jcampos83/Offgridforall_SHS5/SHS_DCDC/Reading/USB A Pinout.jpg

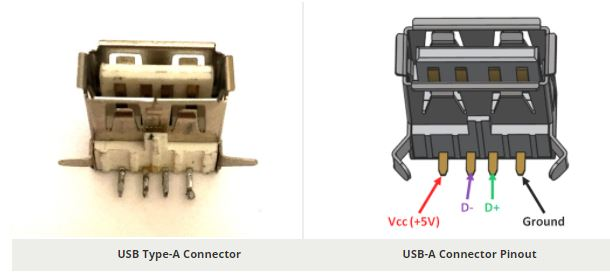
SHS_DCDC/Reading/USB A Pinout.jpg
