jcampos83/Offgridforall_SHS5/SHS_DCDC/Components/MCU/ESP32/ESP32ProgrammingDiagram-970x1024.png

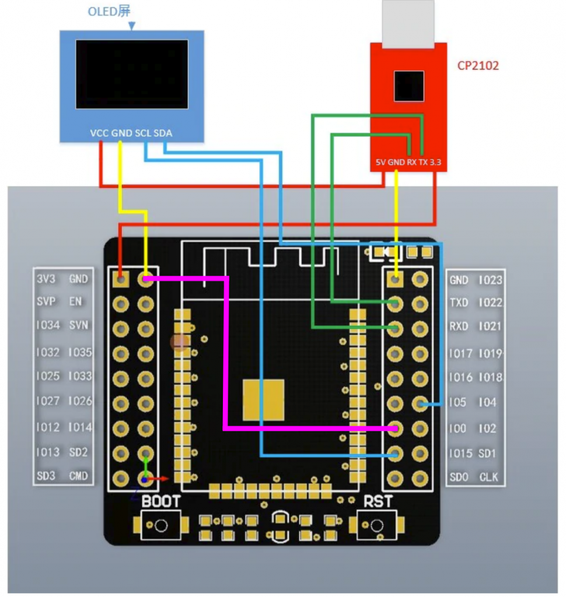
SHS_DCDC/Components/MCU/ESP32/ESP32ProgrammingDiagram-970x1024.png
