jcampos83/Offgridforall_SHS5/SHS_DCDC/Components/MCU/ESP32/ESP32 dev kit schem example.jpg

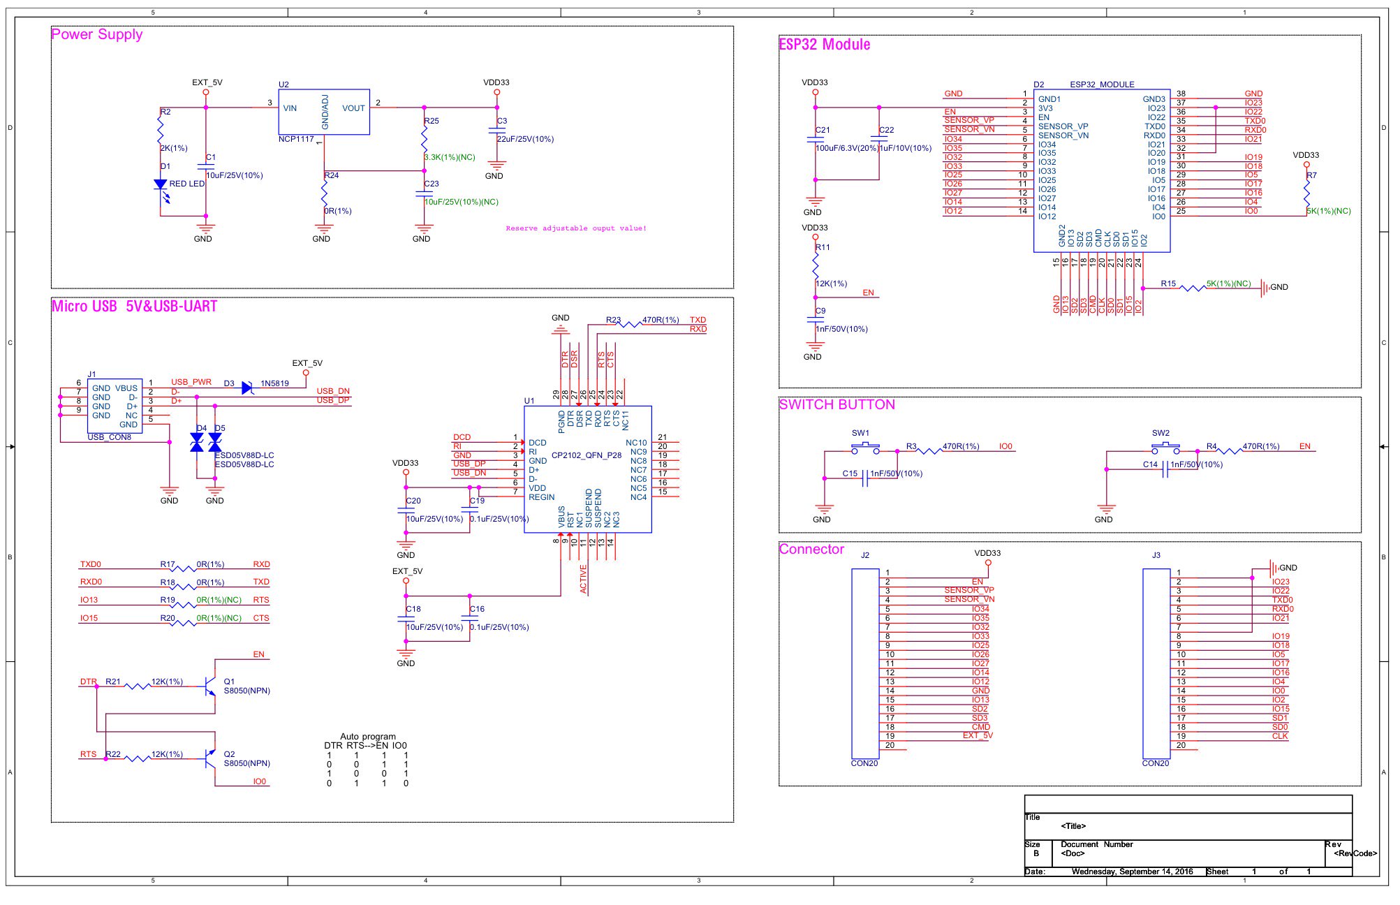
SHS_DCDC/Components/MCU/ESP32/ESP32 dev kit schem example.jpg
