jcampos83/Offgridforall_SHS5/SHS_DCDC/Components/3D model/KEYSTONE - 5029.step

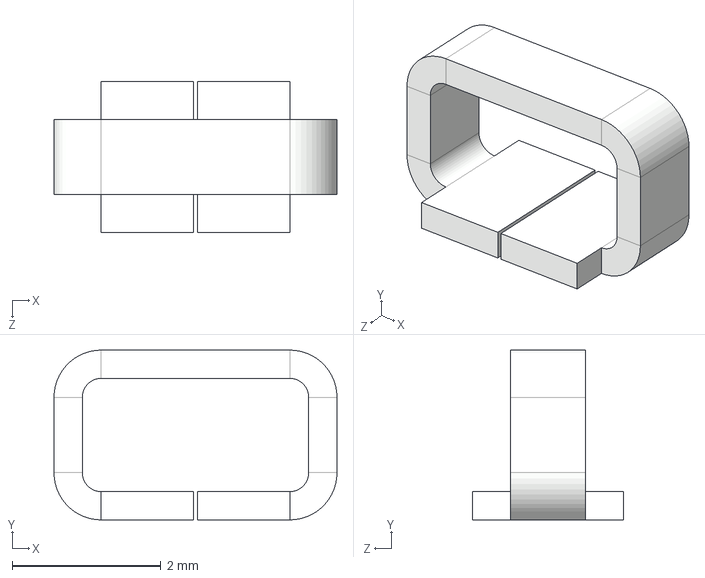
[picture p4: CAD file, 2023-10-24]
SHS_DCDC/Components/3D model/KEYSTONE - 5029.step
3.81 x 2.29 x 2.03 mm
