jcampos83/Offgridforall_SHS5/SHS_DCDC/Components/3D model/BIVAR__INC_VLP-400-F.step

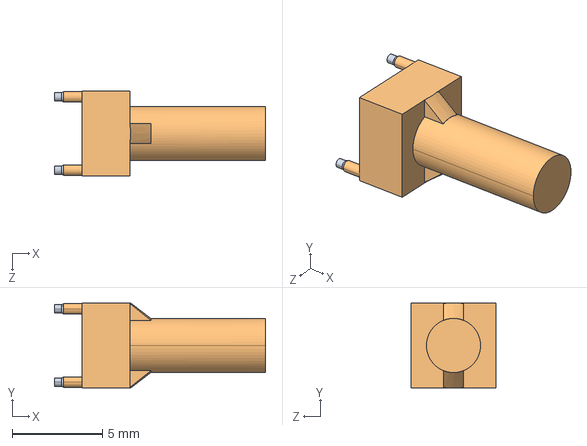
[picture p5: CAD file, 2023-09-13]
SHS_DCDC/Components/3D model/BIVAR__INC_VLP-400-F.step
11.7 x 4.70 x 4.70 mm
