jcampos83/Offgridforall_SHS5/SHS_DCDC/Components/3D model/PTS645SM43SMTR92LFS.stp

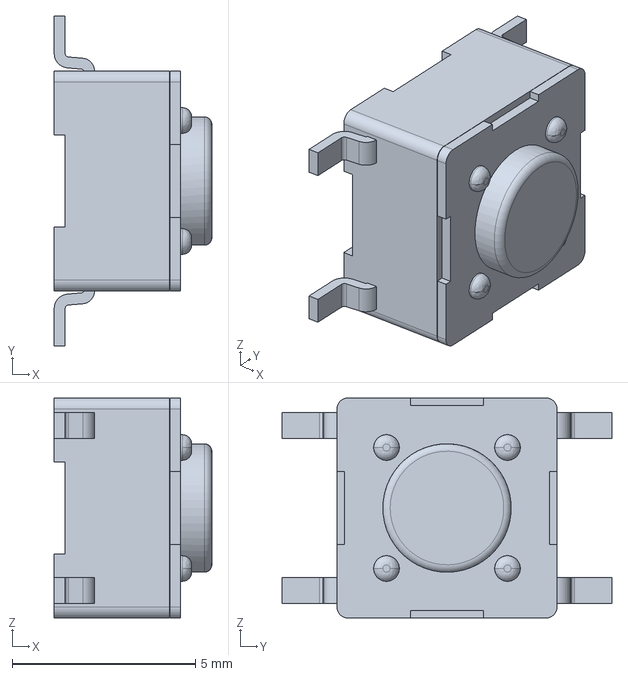
[picture p6: CAD file, 2023-08-12]
SHS_DCDC/Components/3D model/PTS645SM43SMTR92LFS.stp
4.30 x 9.00 x 6.00 mm
