jcampos83/Offgridforall_SHS5/SHS_DCDC/Components/3D model/PJ-059A.stp

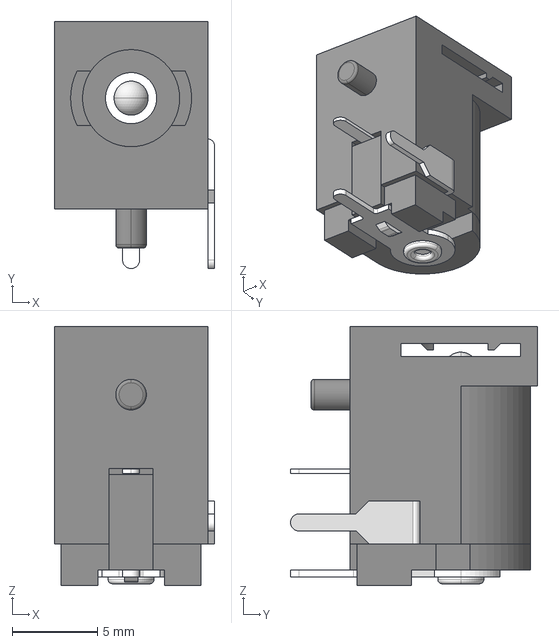
[picture p7: CAD file, 2023-04-24]
SHS_DCDC/Components/3D model/PJ-059A.stp
9.40 x 14.5 x 15.2 mm
