jcampos83/Offgridforall_SHS5/SHS_DCDC/Components/3D model/TSOT23-8_MP3414A_MNP.step

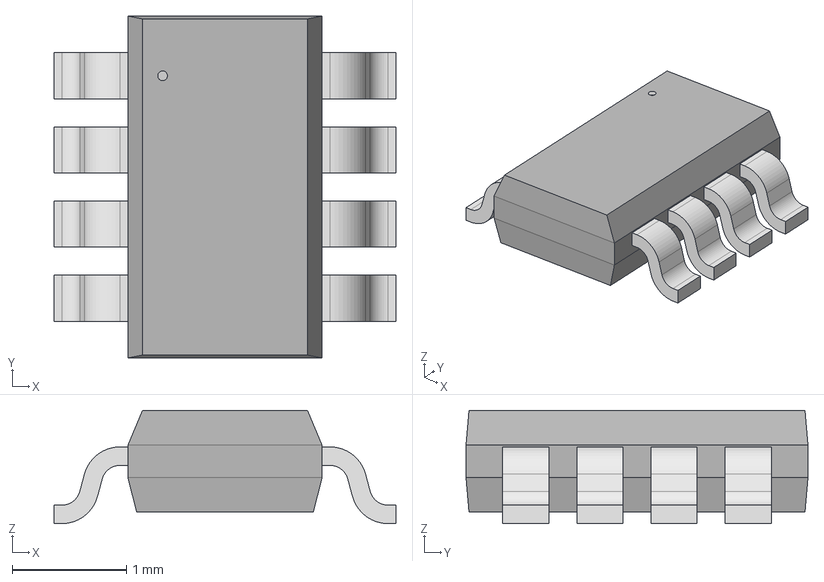
[picture p8: CAD file, 2023-04-24]
SHS_DCDC/Components/3D model/TSOT23-8_MP3414A_MNP.step
3.00 x 3.00 x 0.993 mm
