jcampos83/Offgridforall_SHS5/SHS_DCDC/Components/3D model/XTAL_ECX-34R_ECS.step

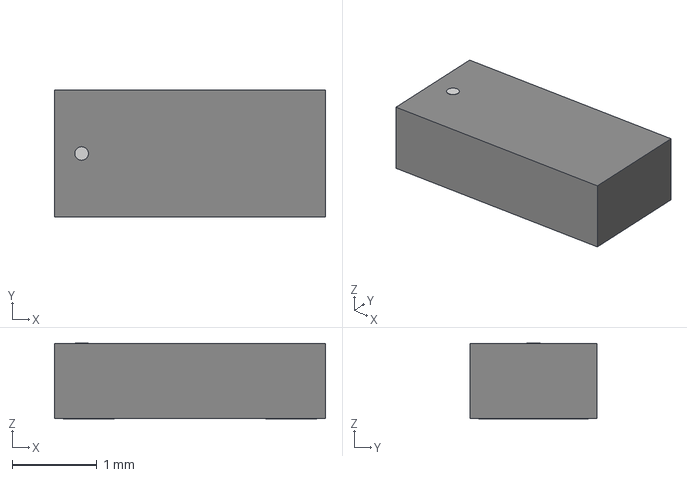
[picture p9: CAD file, 2023-04-24]
SHS_DCDC/Components/3D model/XTAL_ECX-34R_ECS.step
3.20 x 1.50 x 0.892 mm
