jcampos83/Offgridforall_SHS5/SHS_DCDC/Components/3D model/TL1105SFxxxx.stp

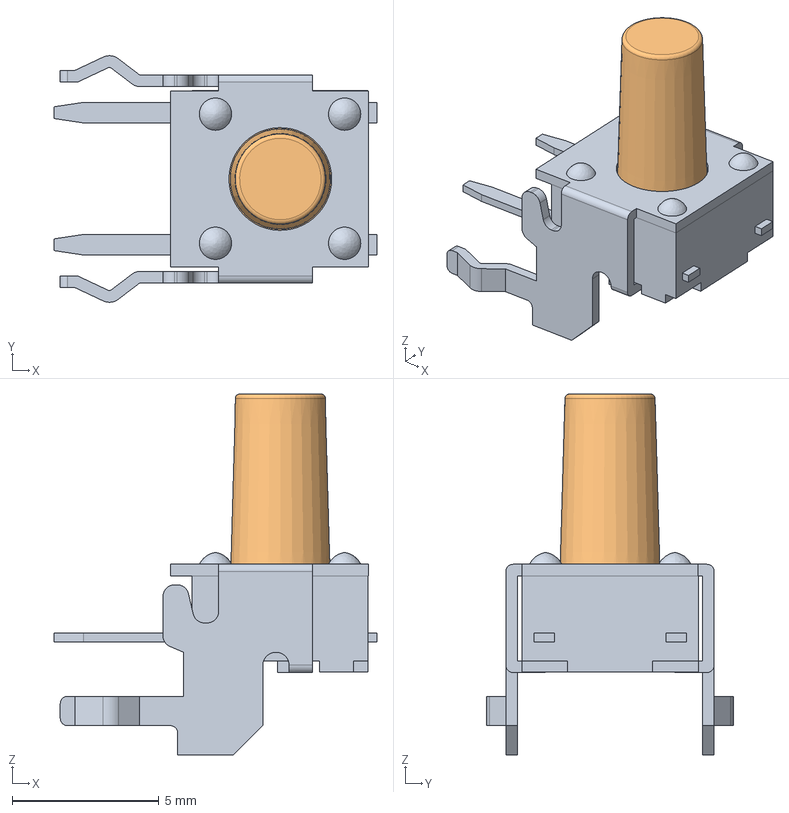
[picture p10: CAD file, 2023-04-24]
SHS_DCDC/Components/3D model/TL1105SFxxxx.stp
11.0 x 8.40 x 12.3 mm
