jcampos83/Offgridforall_SHS5/SHS_DCDC/Components/3D model/IND_TAIYO_NR8040_TAY.step

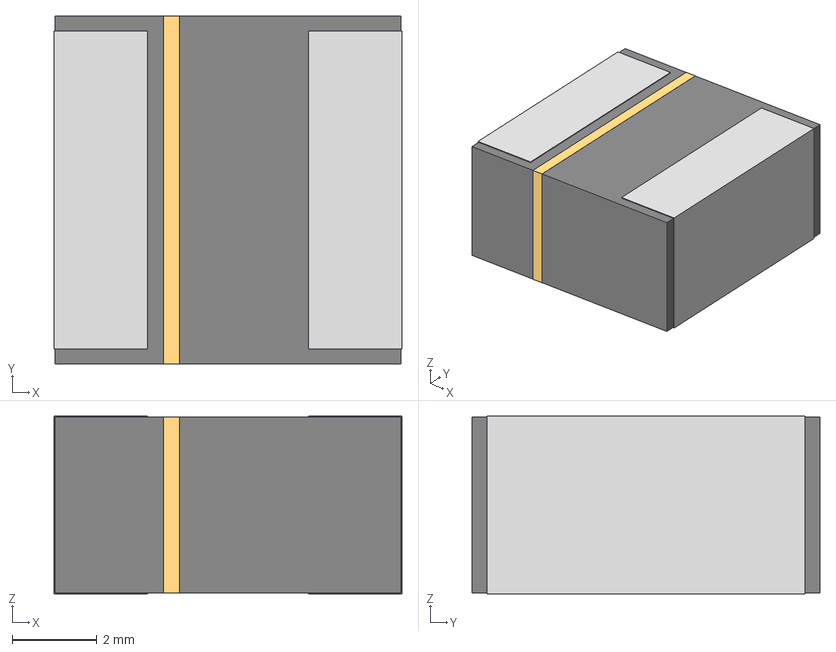
[picture p11: CAD file, 2023-04-17]
SHS_DCDC/Components/3D model/IND_TAIYO_NR8040_TAY.step
8.20 x 8.21 x 4.19 mm
