jcampos83/Offgridforall_SHS5/SHS_DCDC/Components/3D model/LMV358IDR.stp

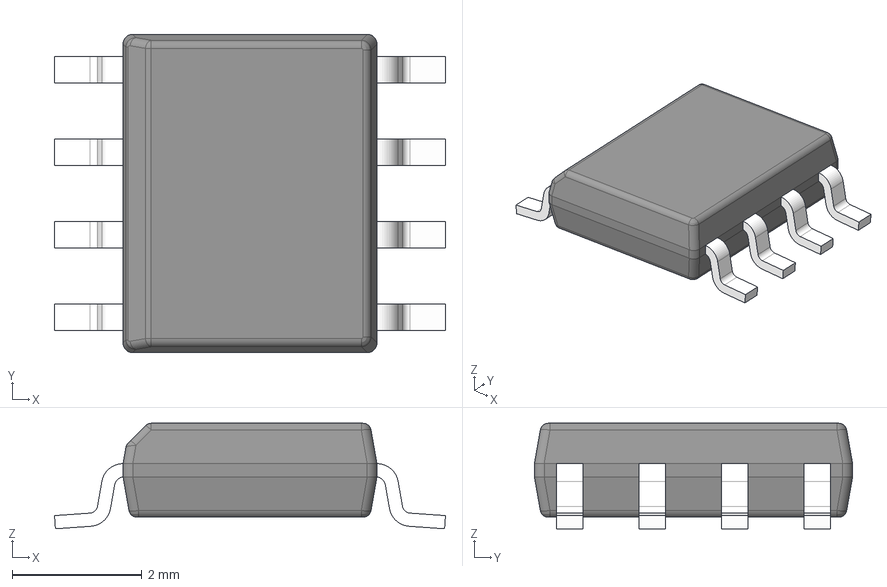
[picture p12: CAD file, 2023-04-17]
SHS_DCDC/Components/3D model/LMV358IDR.stp
6.02 x 4.90 x 1.63 mm
BODY-SO
LEAD-D0008A x 8
