jcampos83/Offgridforall_SHS5/SHS_DCDC/Components/3D model/USB-A-S-S-W-TH.stp

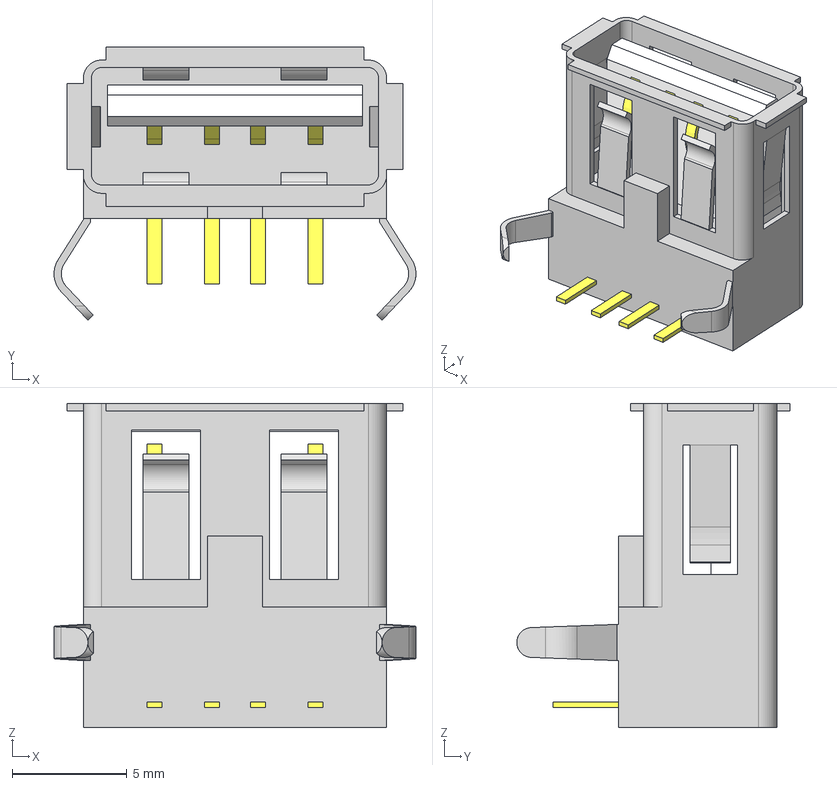
[picture p13: CAD file, 2023-04-17]
SHS_DCDC/Components/3D model/USB-A-S-S-W-TH.stp
15.7 x 11.9 x 14.1 mm
USB-A-S-TH_P
USB-A-S-W-TH_B
USB-A-S-TH_S
