jcampos83/Offgridforall_SHS5/SHS_DCDC/Components/3D model/IND_TAIYO_NR6028_TAY.step

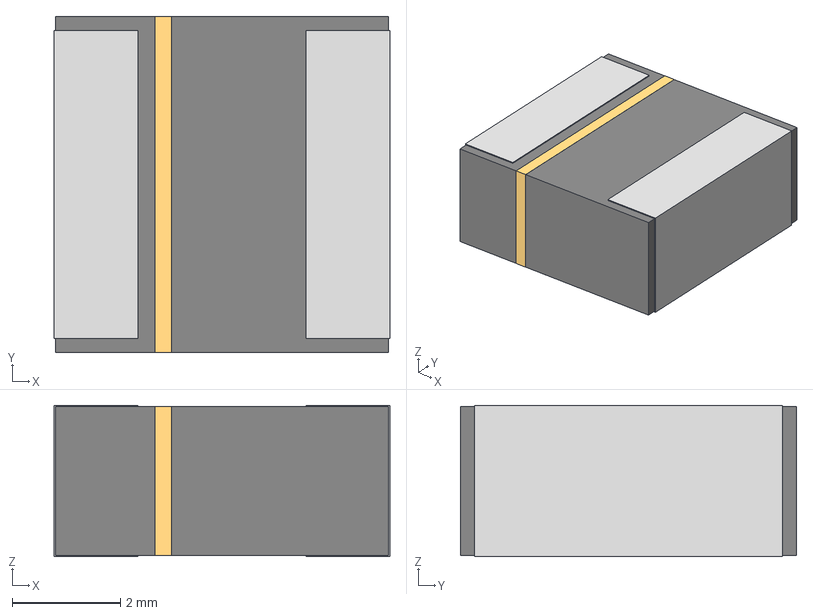
[picture p14: CAD file, 2023-04-17]
SHS_DCDC/Components/3D model/IND_TAIYO_NR6028_TAY.step
6.20 x 6.20 x 2.79 mm
