jcampos83/Offgridforall_SHS5/SHS_DCDC/Components/3D model/TL1105QFxxxx.stp

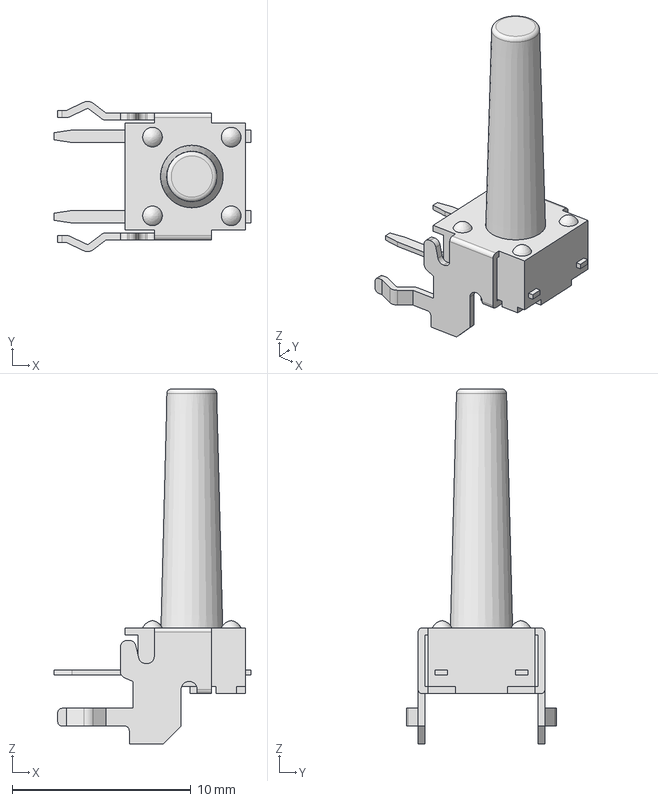
[picture p15: CAD file, 2023-04-17]
SHS_DCDC/Components/3D model/TL1105QFxxxx.stp
11.0 x 8.40 x 19.9 mm
