jcampos83/Offgridforall_SHS5/SHS_DCDC/Components/3D model/CUI_DEVICES_PJ-202A.step

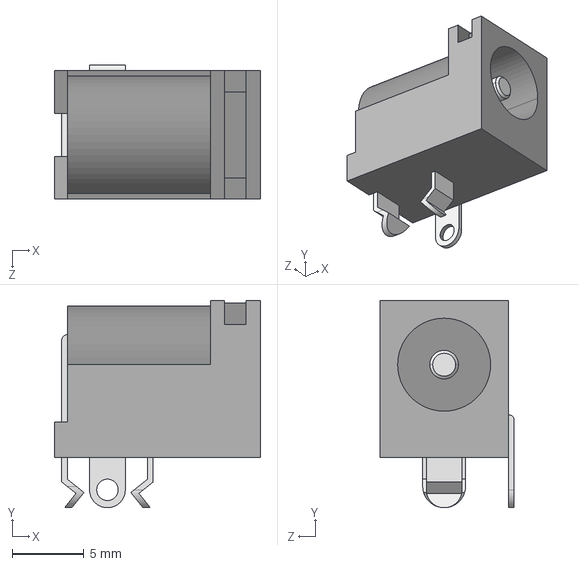
[picture p16: CAD file, 2023-04-17]
SHS_DCDC/Components/3D model/CUI_DEVICES_PJ-202A.step
14.4 x 14.5 x 9.40 mm
