jcampos83/Offgridforall_SHS5/SHS_DCDC/Components/3D model/RT8299 WDFN.step

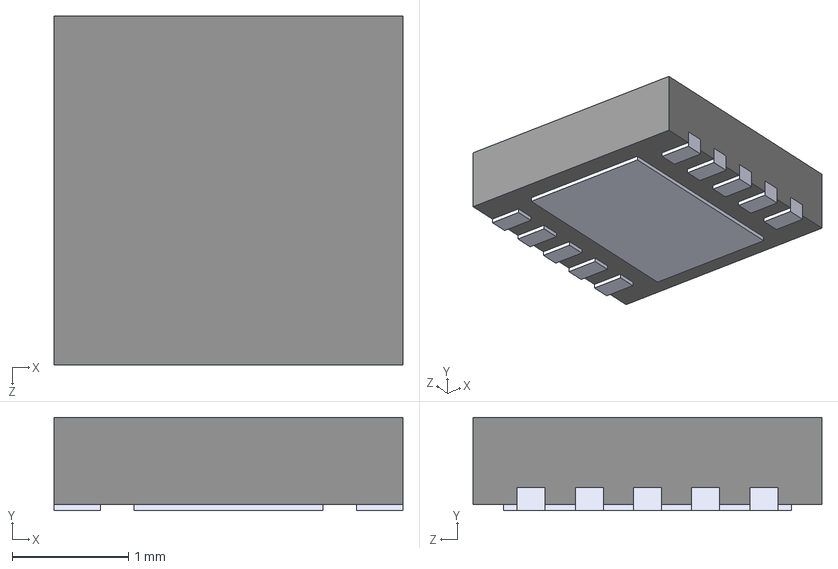
[picture p17: CAD file, 2021-10-31]
SHS_DCDC/Components/3D model/RT8299 WDFN.step
3.00 x 0.8 x 3.00 mm
