jcampos83/Offgridforall_SHS5/SHS_DCDC/Components/3D model/LMV324AIDR.STEP

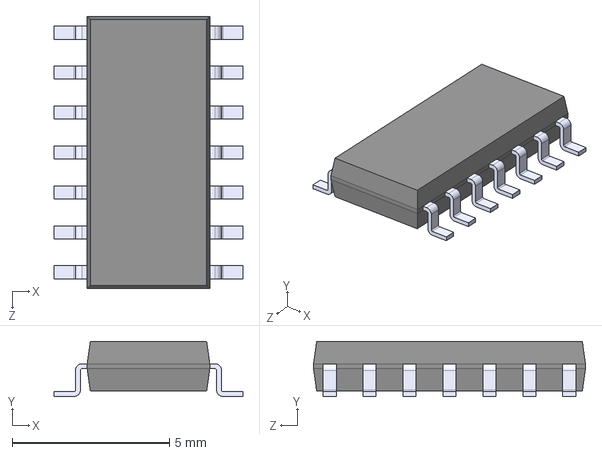
[picture p18: CAD file, 2021-10-04]
SHS_DCDC/Components/3D model/LMV324AIDR.STEP
6.00 x 1.75 x 8.65 mm
