jcampos83/Offgridforall_SHS5/SHS_DCDC/Components/3D model/RJ45_54602-908LFc.stp

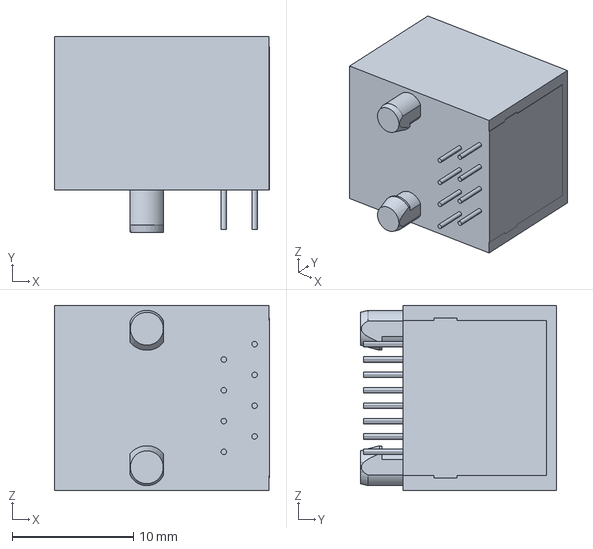
[picture p19: CAD file, 2021-10-04]
SHS_DCDC/Components/3D model/RJ45_54602-908LFc.stp
17.7 x 16.2 x 15.3 mm
