jcampos83/Offgridforall_SHS5/SHS_DCDC/Components/3D model/BK-18650-PC8.STEP

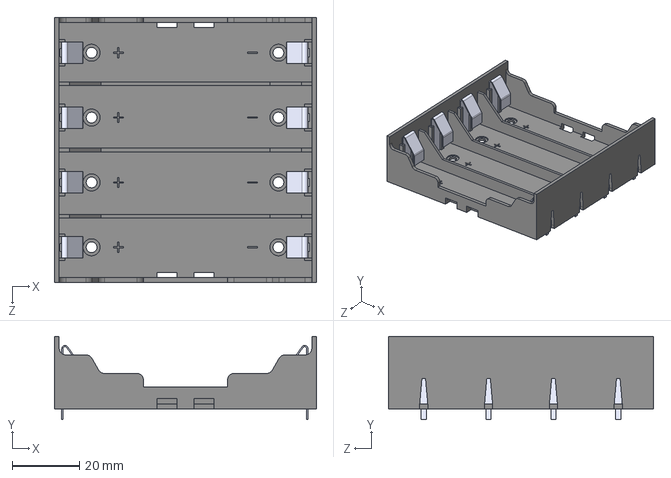
[picture p20: CAD file, 2021-10-04]
SHS_DCDC/Components/3D model/BK-18650-PC8.STEP
78.0 x 24.7 x 78.8 mm
