jcampos83/Offgridforall_SHS5/SHS_DCDC/Components/3D model/Keystone - 1108.STEP

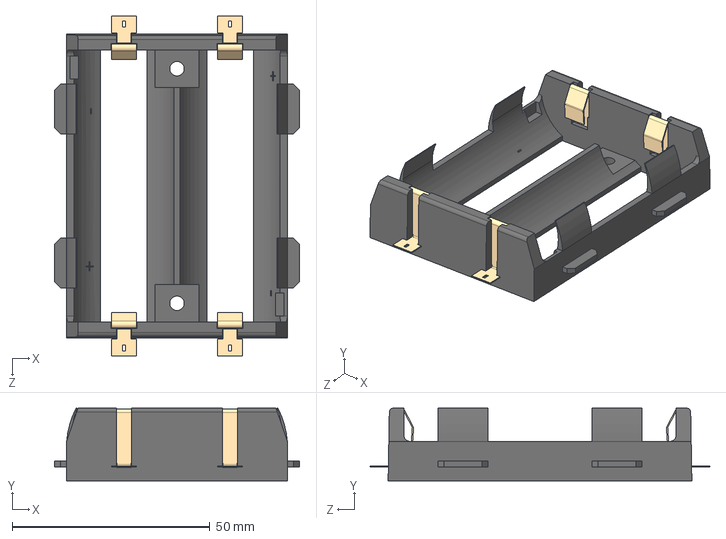
[picture p21: CAD file, 2021-10-04]
SHS_DCDC/Components/3D model/Keystone - 1108.STEP
62.0 x 18.4 x 86.0 mm
