jcampos83/Offgridforall_SHS5/SHS_DCDC/Components/DCDC Converter/Richtek - Buck_RT8299_footprint.pdf

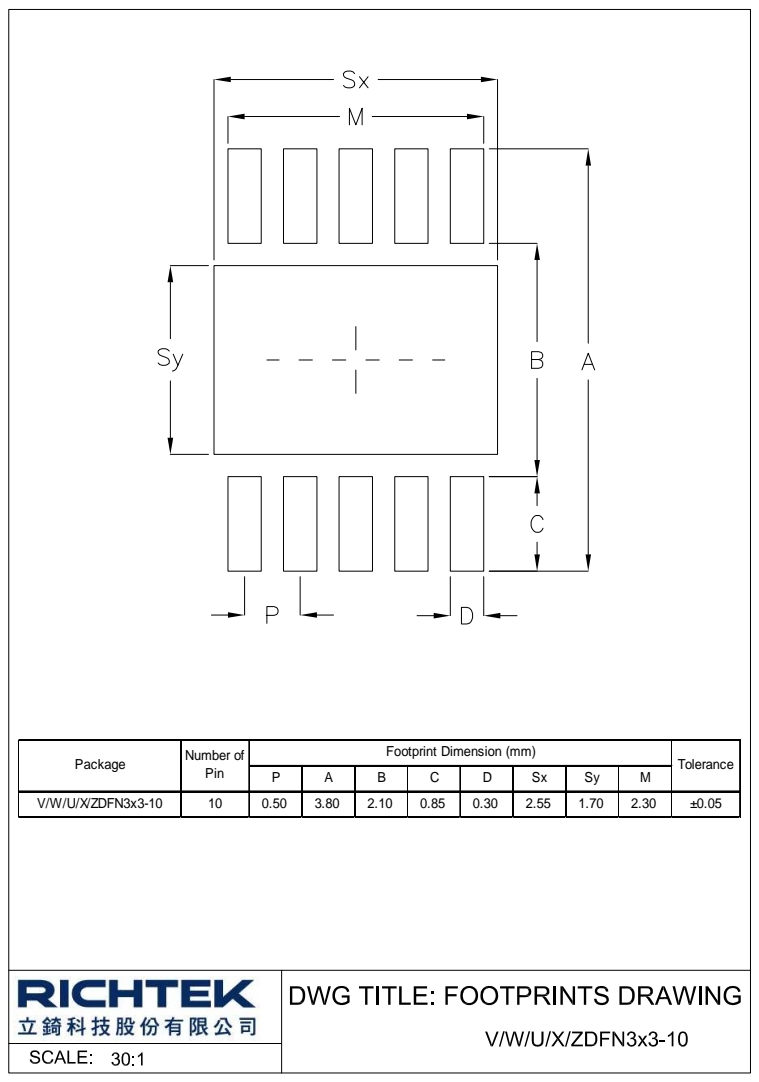
[picture p22: page 1]

Package | Pin | Footprint Dimension (mm) | Tolerance Number of

V/W/U/X/ZDFN3x3-10 | 10 | 0.50 | 3.80 | 2.10 | 0.85 | 0.30 | 2.55 | 1.70 | 2.30 | ±0.05
