jcampos83/Offgridforall_SHS5/SHS_DCDC/Simulation/PV - Reverse current (BAT) protection.asc

C1: cap; 20µ
D2: diode; 1N4148
D3: diode; 1N4148
M1: nmos; 2N7002
M2: pmos; AO6407
M4: pmos; AO6407
M5: pmos; BSS84
R1: res; 100k
R2: res; 100k
R3: res; 47k
R5: res; 100k
R7: res; 100k
V1: voltage; 5
V3: voltage; 3.3
V4: voltage; 2.7; Rser=10
Named nets: 0
.tran 1 startup
