jcampos83/Offgridforall_SHS5/SHS_DCDC/Simulation/Current Sensing Block V1 (bat).asc

BAT: voltage; 3; Rser=1
I1: current; SINE(0 2 1 0 0 0 1)
R1: res; 1k
R2: res; 100k
R3: res; 100k
R4: res; 1k
SHUNT: res; 0.005
U1: UniversalOpAmp2
V1: voltage; 1.65
V2: voltage; 3.3
Named nets: 0, OPAMP+, IN-, IN+, VREF, I_PV->V
.tran 1
