jcampos83/Offgridforall_SHS5/SHS_DCDC/Simulation/Current Sensing Block V2 (PV).asc

A: UniversalOpAmp2
C: UniversalOpAmp2
D: UniversalOpAmp2
I1: current; SINE(1 1 1 0 0 0 1)
LOAD: res; 1
R1: res; 1k
R2: res; 100k
R3: res; 100k
R4: res; 1k
SHUNT: res; 0.005
V2: voltage; 3.3
Named nets: 0, OPAMP+, DCDC_OUT, LOAD, PV_I, OP_V2-, OP_V1-, OP_VS+, OP_VS-
.tran 1
