jcampos83/Offgridforall_SHS5/SHS_DCDC/Simulation/Autoswitch - DCDC.asc

C1: cap; 100n
D1: diode; 1N4148
D2: diode; 1N4148
D3: diode; 1N4148
M1: pmos; AO6407
M2: pmos; AO6407
M3: pmos; BSS84
R1: res; 100k
R2: res; 470k
R3: res; 1k
V1: voltage; 3.6
V2: voltage; PULSE(0 3.3 0.5 1n 1n 0.5 1 1)
Named nets: 0
.tran 1
