jcampos83/Offgridforall_SHS5/SHS_DCDC/SHS_DCDC.kicad_pcb

## KiCad design SHS_DCDC/SHS_DCDC.kicad_pcb (2023-10-17)

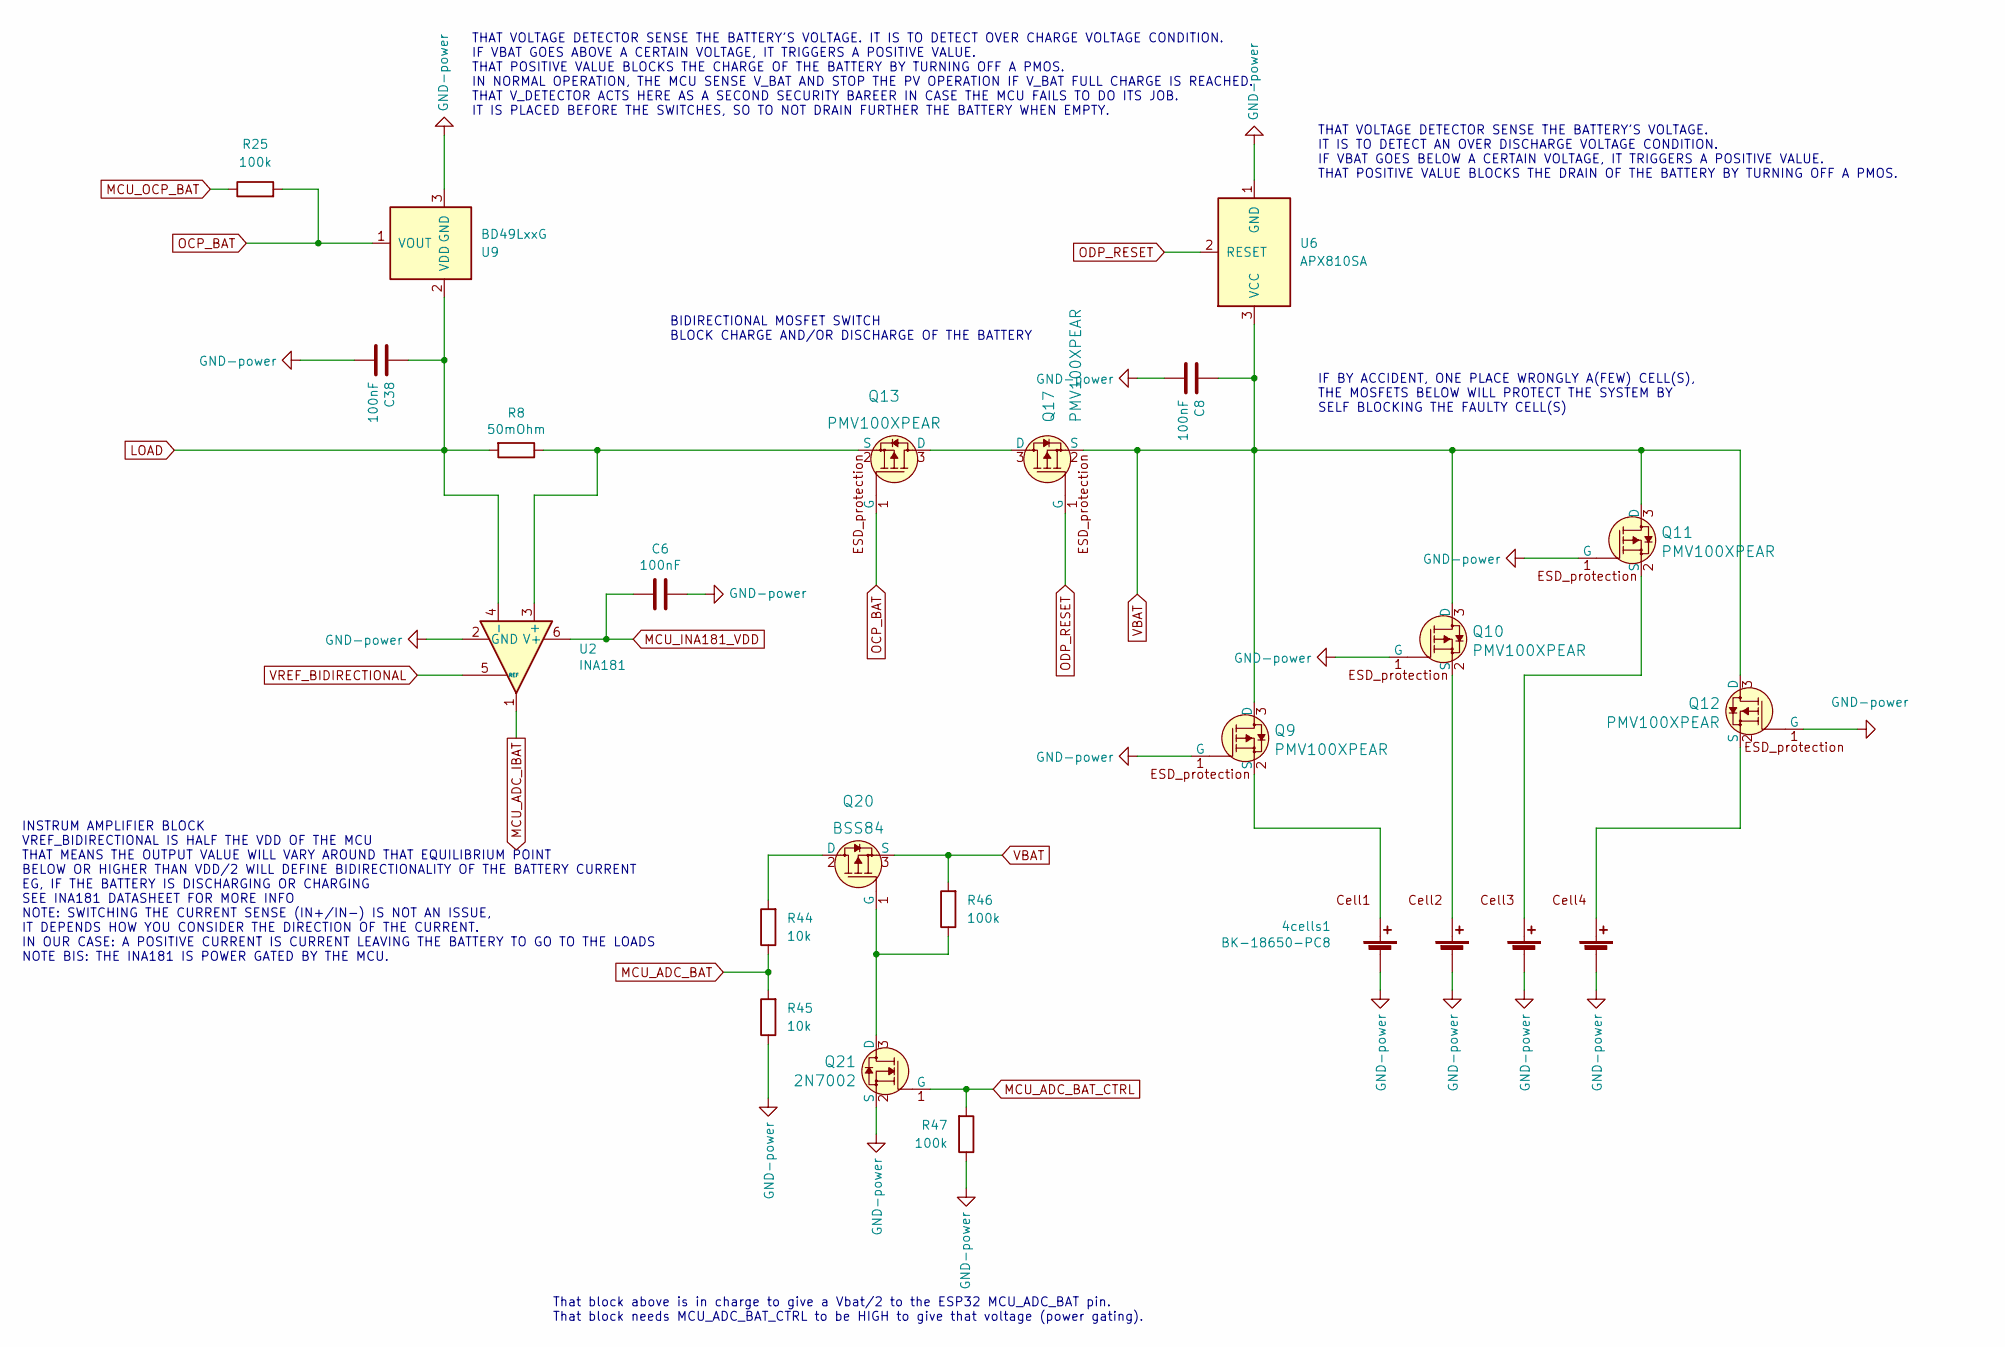
[picture p23: schematic BAT.kicad_sch]

Parts:
4cells1: BK-18650-PC8
C6, C8, C38: 100nF; C_0402_1005Metric
Q9, Q10, Q11, Q12, Q13, Q17: PMV100XPEAR; SOT-23-3; MPN PMV100XPEAR
Q20: BSS84; SOT-23; MPN BSS84; Digi-Key_PN BSS84CT-ND
Q21: 2N7002; SOT-23; MPN 2N7002; Digi-Key_PN 2N7002NCT-ND
R8: 50mOhm; R_2010_5025Metric
R25, R46, R47: 100k; R_0402_1005Metric
R44, R45: 10k; R_0402_1005Metric
U2: INA181; SOT-23-6
U6: APX810SA; SOT-23
U9: BD49LxxG; SOT-23

Connections:
GND: 4cells1.2 (-), 4cells1.4 (-), 4cells1.6 (-), 4cells1.8 (-), C6.1, C8.2, C38.2, Q9.1 (G), Q10.1 (G), Q11.1 (G), Q12.1 (G), Q21.2 (S), R45.1, R47.1, U2.2 (GND), U6.1 (GND), U9.3 (GND); also elsewhere on the board
LOAD: C38.1, R8.2, U2.4 (-), U9.2 (VDD); also elsewhere on the board
MCU_ADC_BAT: R44.1, R45.2; also elsewhere on the board
MCU_ADC_BAT_CTRL: Q21.1 (G), R47.2; also elsewhere on the board
MCU_ADC_IBAT: U2.1; also elsewhere on the board
MCU_INA181_VDD: C6.2, U2.6 (V+); also elsewhere on the board
MCU_OCP_BAT: R25.1; also elsewhere on the board
unnamed: 4cells1.1 (+), Q9.2 (S)
unnamed: 4cells1.3 (+), Q10.2 (S)
unnamed: 4cells1.5 (+), Q11.2 (S)
unnamed: 4cells1.7 (+), Q12.2 (S)
unnamed: Q13.2 (S), R8.1, U2.3 (+)
unnamed: Q13.3 (D), Q17.3 (D)
unnamed: Q20.1 (G), Q21.3 (D), R46.1
unnamed: Q20.2 (D), R44.2
OCP_BAT: Q13.1 (G), R25.2, U9.1 (VOUT)
ODP_RESET: Q17.1 (G), U6.2 (RESET); also elsewhere on the board
VBAT: C8.1, Q9.3 (D), Q10.3 (D), Q11.3 (D), Q12.3 (D), Q17.2 (S), Q20.3 (S), R46.2, U6.3 (VCC)
VREF_BIDIRECTIONAL: U2.5 (REF); also elsewhere on the board

Notes on the sheet:
IF BY ACCIDENT, ONE PLACE WRONGLY A(FEW) CELL(S), THE MOSFETS BELOW WILL PROTECT THE SYSTEM BY SELF BLOCKING THE FAULTY CELL(S)
BIDIRECTIONAL MOSFET SWITCH BLOCK CHARGE AND/OR DISCHARGE OF THE BATTERY
THAT VOLTAGE DETECTOR SENSE THE BATTERY'S VOLTAGE. IT IS TO DETECT AN OVER DISCHARGE VOLTAGE CONDITION. IF VBAT GOES BELOW A CERTAIN VOLTAGE, IT TRIGGERS A POSITIVE VALUE. THAT POSITIVE VALUE BLOCKS THE DRAIN OF THE BATTERY BY TURNING OFF A PMOS.
That block above is in charge to give a Vbat/2 to the ESP32 MCU_ADC_BAT pin. That block needs MCU_ADC_BAT_CTRL to be HIGH to give that voltage (power gating).
THAT VOLTAGE DETECTOR SENSE THE BATTERY'S VOLTAGE. IT IS TO DETECT OVER CHARGE VOLTAGE CONDITION. IF VBAT GOES ABOVE A CERTAIN VOLTAGE, IT TRIGGERS A POSITIVE VALUE. THAT POSITIVE VALUE BLOCKS THE CHARGE OF THE BATTERY BY TURNING OFF A PMOS. IN NORMAL OPERATION, THE MCU SENSE V_BAT AND STOP THE PV 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
INSTRUM AMPLIFIER BLOCK VREF_BIDIRECTIONAL IS HALF THE VDD OF THE MCU THAT MEANS THE OUTPUT VALUE WILL VARY AROUND THAT EQUILIBRIUM POINT BELOW OR HIGHER THAN VDD/2 WILL DEFINE BIDIRECTIONALITY OF THE BATTERY CURRENT EG, IF THE BATTERY IS DISCHARGING OR CHARGING SEE INA181 DATASHEET FOR MORE INFO N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

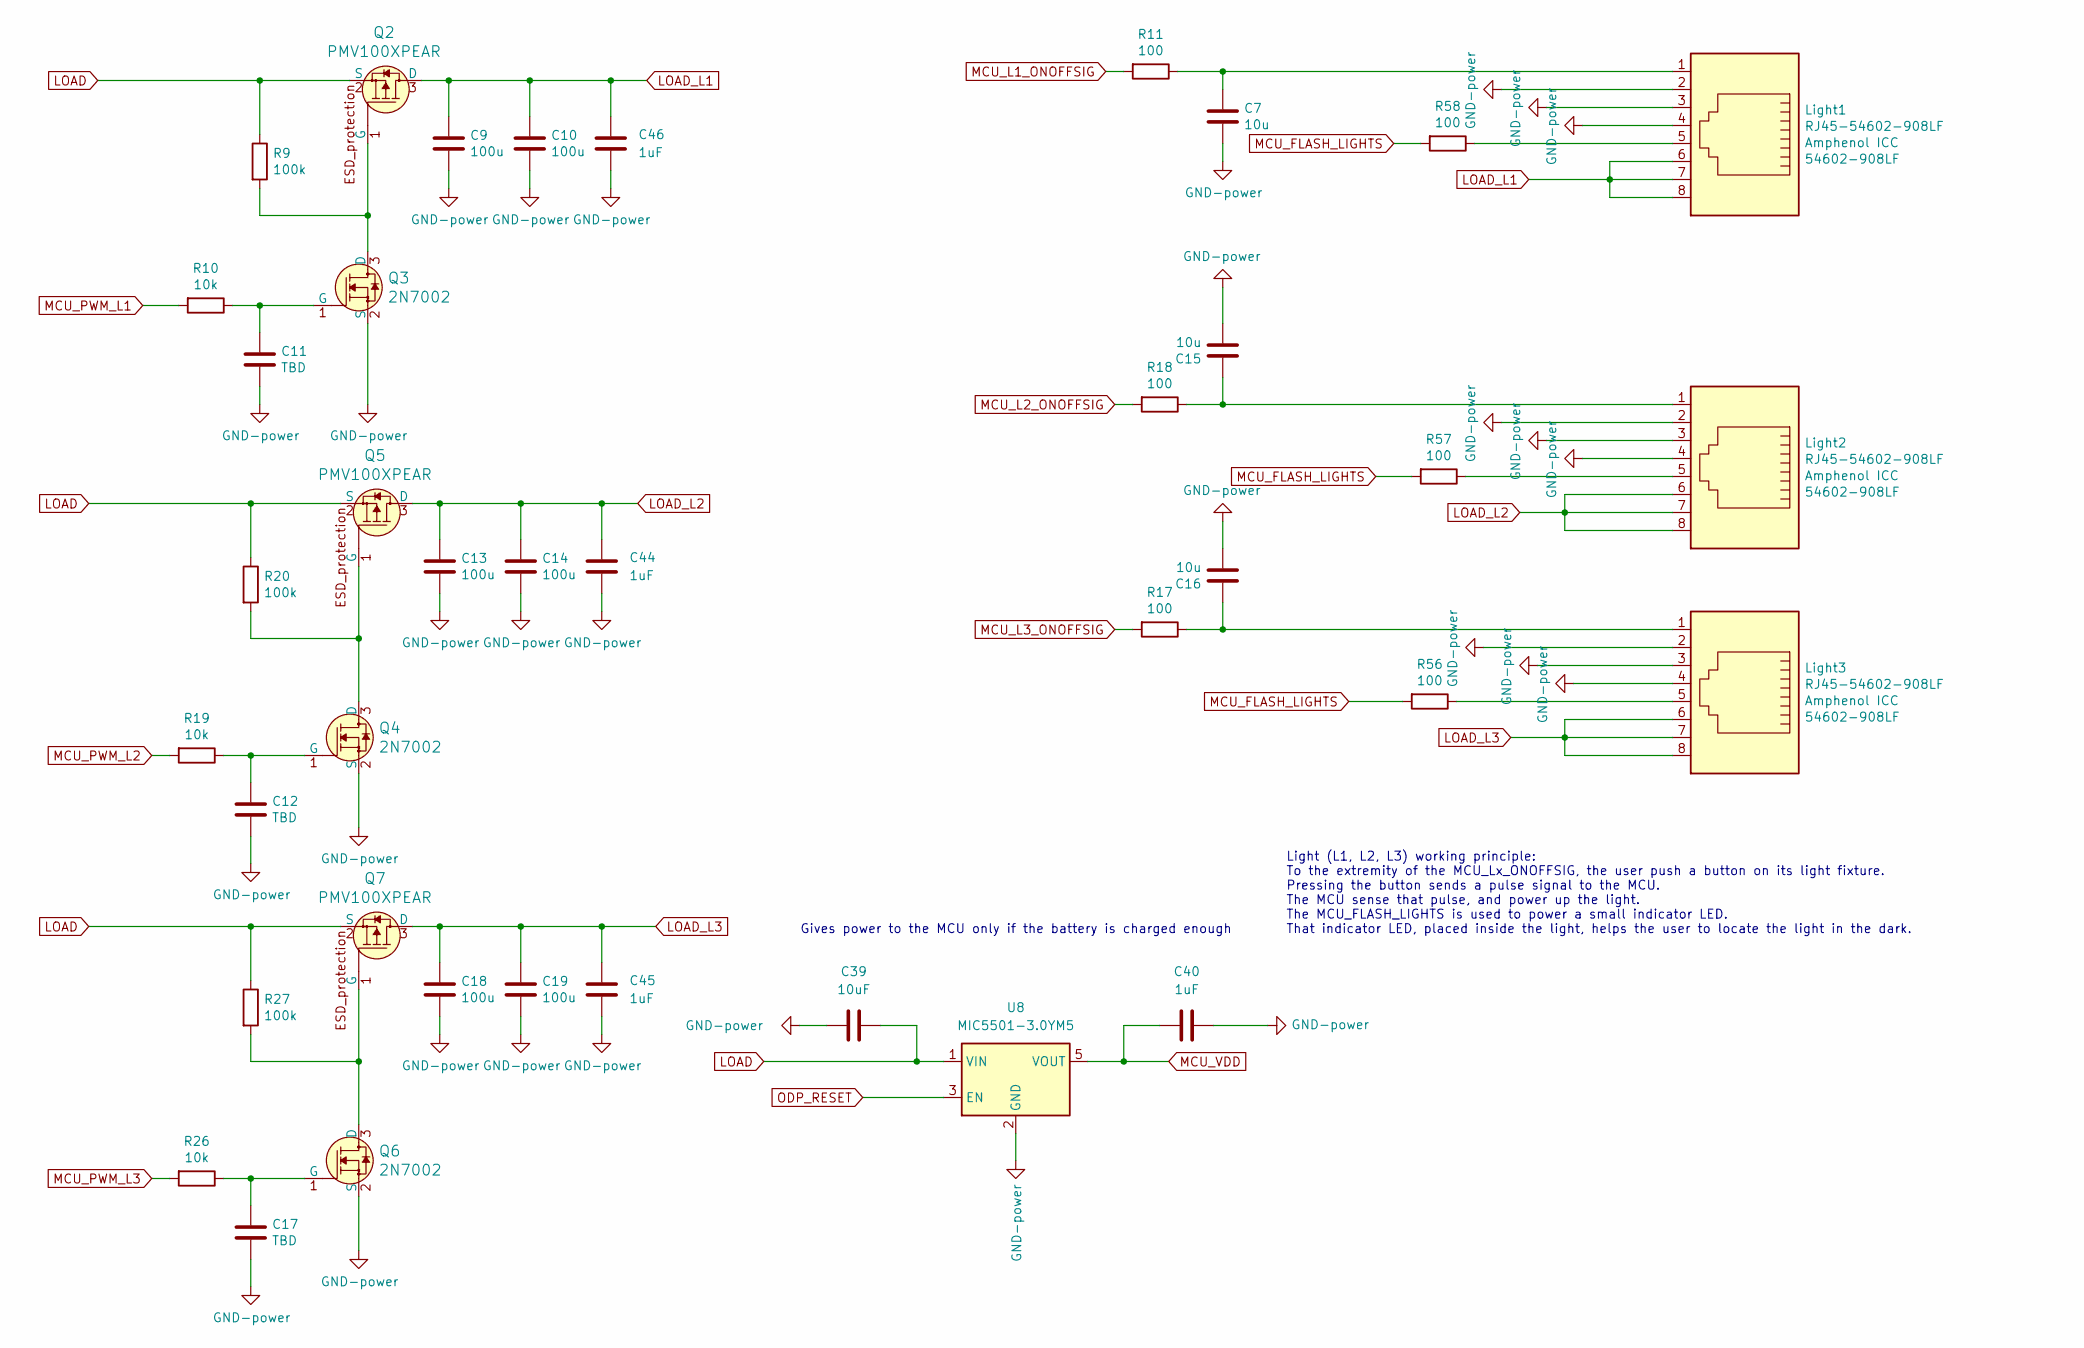
[picture p24: schematic LOAD.kicad_sch]

Parts:
C7, C15, C16: 10u; C_0603_1608Metric
C9, C10, C13, C14, C18, C19: 100u; C_1210_3225Metric
C11, C12, C17: TBD; C_0603_1608Metric
C39: 10uF; C_0805_2012Metric
C40: 1uF; C_0603_1608Metric
C44, C45, C46: 1uF; C_0402_1005Metric
Light1, Light2, Light3: RJ45-54602-908LF; RJ45_Amphenol_54602-x08_Horizontal
Q2, Q5, Q7: PMV100XPEAR; SOT-23-3; MPN PMV100XPEAR
Q3, Q4, Q6: 2N7002; SOT-23-3; MPN 2N7002; Digi-Key_PN 2N7002NCT-ND
R9, R20, R27: 100k; R_0603_1608Metric
R10, R19, R26: 10k; R_0603_1608Metric
R11, R17, R18, R56, R57, R58: 100; R_0603_1608Metric
U8: MIC5501-3.0YM5; SOT-23-5

Connections:
GND: C7.2, C9.2, C10.2, C11.2, C12.2, C13.2, C14.2, C15.2, C16.2, C17.2, C18.2, C19.2, C39.1, C40.2, C44.2, C45.2, C46.2, Light1.2, Light1.3, Light1.4, Light2.2, Light2.3, Light2.4, Light3.2, Light3.3, Light3.4, Q3.2 (S), Q4.2 (S), Q6.2 (S), U8.2 (GND); also elsewhere on the board
LOAD: C39.2, Q2.2 (S), Q5.2 (S), Q7.2 (S), R9.1, R20.1, R27.1, U8.1 (VIN); also elsewhere on the board
LOAD_L1: C9.1, C10.1, C46.1, Light1.6, Light1.7, Light1.8, Q2.3 (D)
LOAD_L2: C13.1, C14.1, C44.1, Light2.6, Light2.7, Light2.8, Q5.3 (D)
LOAD_L3: C18.1, C19.1, C45.1, Light3.6, Light3.7, Light3.8, Q7.3 (D)
MCU_FLASH_LIGHTS: R56.2, R57.2, R58.2; also elsewhere on the board
MCU_L1_ONOFFSIG: R11.2; also elsewhere on the board
MCU_L2_ONOFFSIG: R18.2; also elsewhere on the board
MCU_L3_ONOFFSIG: R17.2; also elsewhere on the board
MCU_PWM_L1: R10.2; also elsewhere on the board
MCU_PWM_L2: R19.2; also elsewhere on the board
MCU_PWM_L3: R26.2; also elsewhere on the board
MCU_VDD: C40.1, U8.5 (VOUT); also elsewhere on the board
unnamed: C7.1, Light1.1, R11.1
unnamed: C11.1, Q3.1 (G), R10.1
unnamed: C12.1, Q4.1 (G), R19.1
unnamed: C15.1, Light2.1, R18.1
unnamed: C16.1, Light3.1, R17.1
unnamed: C17.1, Q6.1 (G), R26.1
unnamed: Light1.5, R58.1
unnamed: Light2.5, R57.1
unnamed: Light3.5, R56.1
unnamed: Q2.1 (G), Q3.3 (D), R9.2
unnamed: Q4.3 (D), Q5.1 (G), R20.2
unnamed: Q6.3 (D), Q7.1 (G), R27.2
ODP_RESET: U8.3 (EN); also elsewhere on the board

Notes on the sheet:
Light (L1, L2, L3) working principle: To the extremity of the MCU_Lx_ONOFFSIG, the user push a button on its light fixture. Pressing the button sends a pulse signal to the MCU. The MCU sense that pulse, and power up the light. The MCU_FLASH_LIGHTS is used to power a small indicator LED. That indica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
Gives power to the MCU only if the battery is charged enough

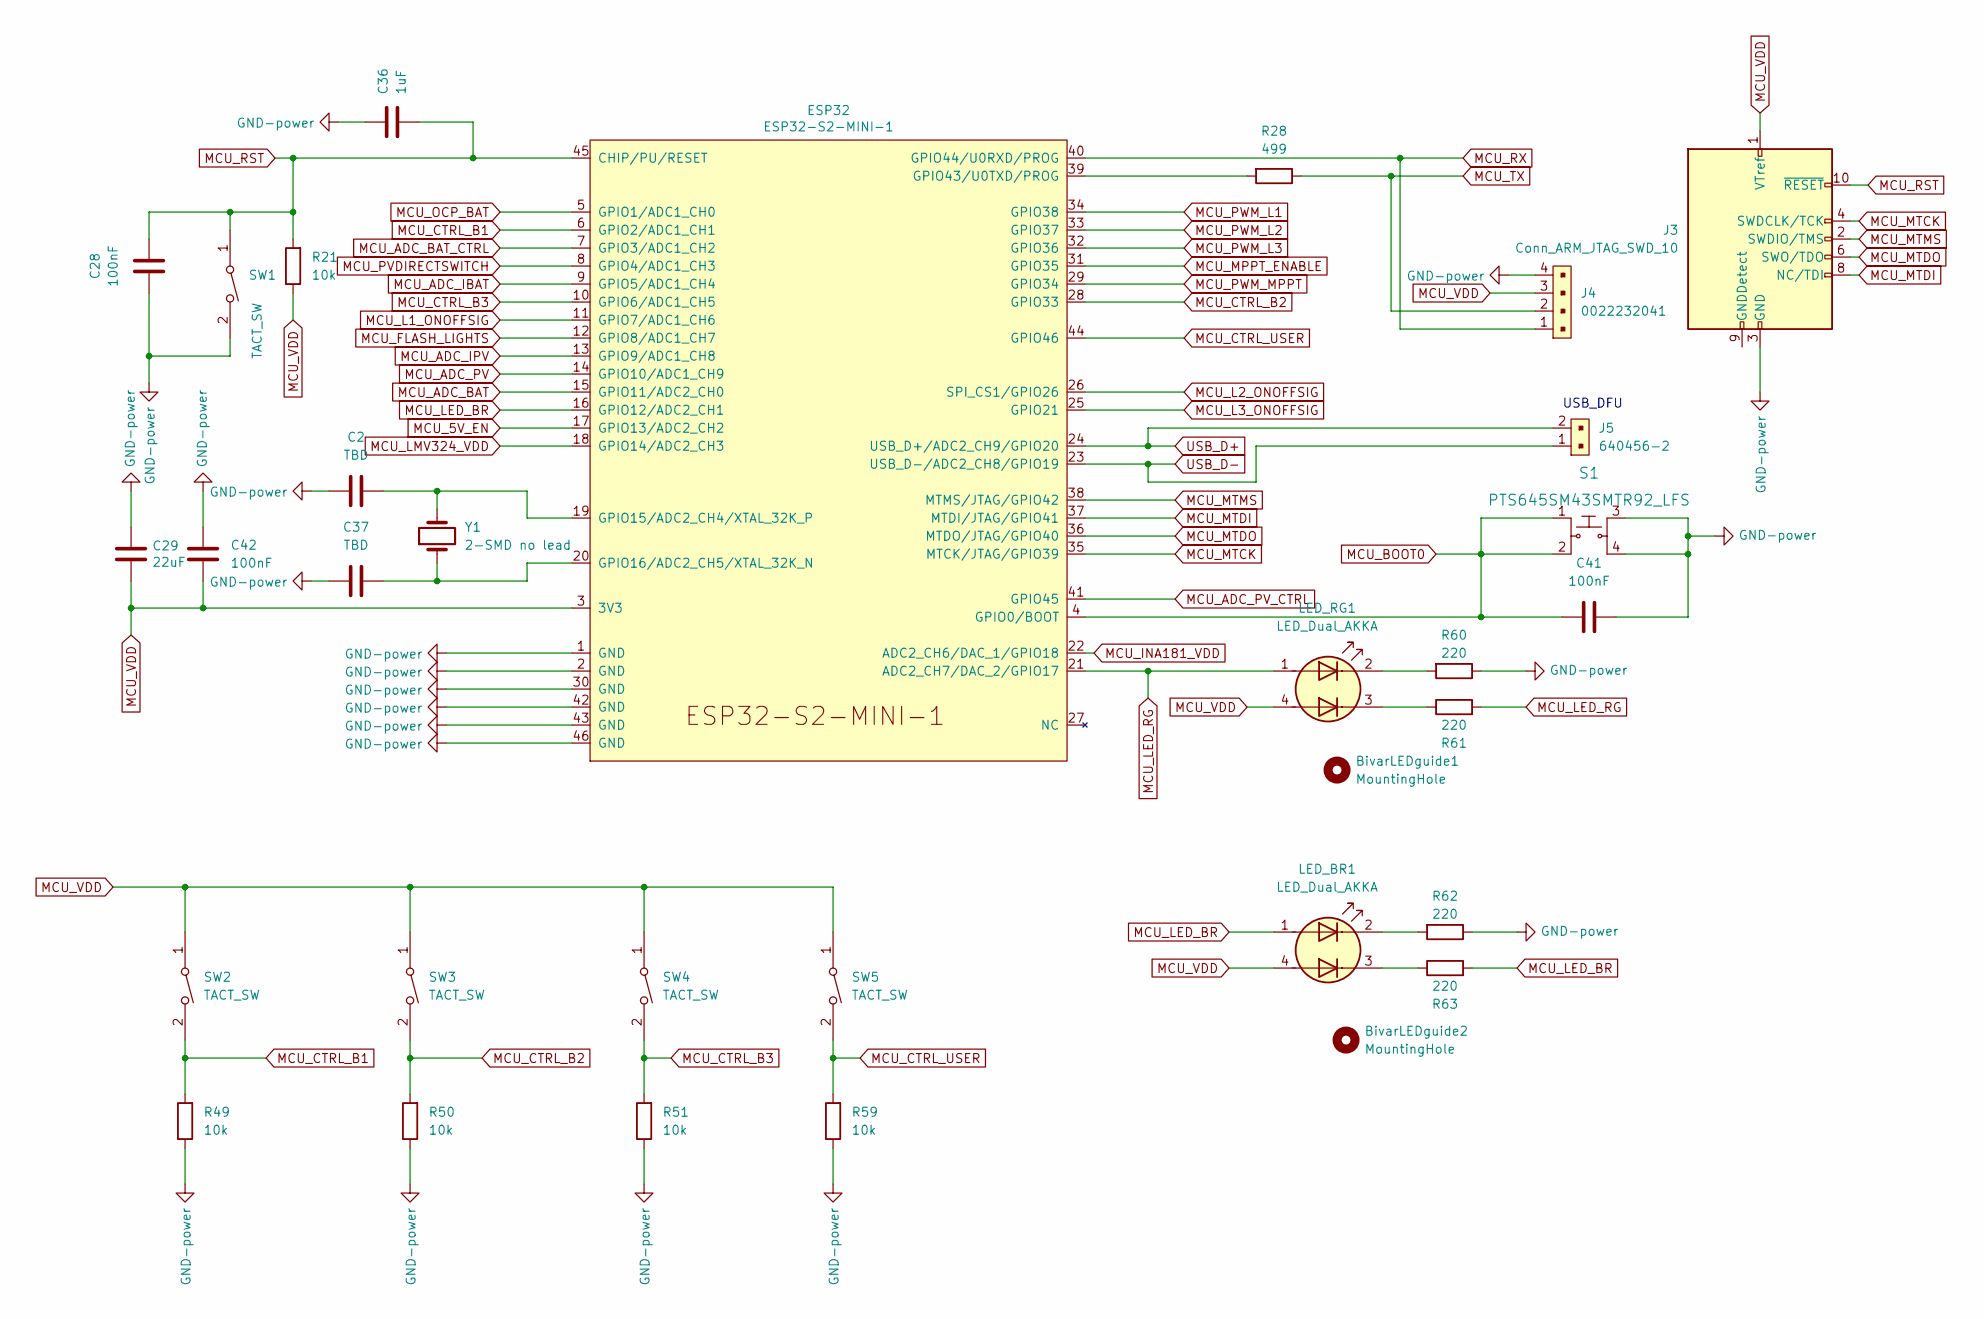
[picture p25: schematic MCU.kicad_sch]

Parts:
BivarLEDguide1, BivarLEDguide2: MountingHole; BIVAR VLP-XXX-F
C2, C37: TBD; C_0402_1005Metric
C28, C41, C42: 100nF; C_0402_1005Metric
C29: 22uF; C_0603_1608Metric
C36: 1uF; C_0402_1005Metric
ESP32: ESP32-S2-MINI-1
J3: Conn_ARM_JTAG_SWD_10; PinHeader_2x05_P1.27mm_Vertical
J4: 0022232041; PinHeader_1x4_P2.54mm_Drill1.02mm; MPN 0022232041; Digi-Key_PN WM4202-ND
J5: 640456-2; PinHeader_1x2_P2.54mm_Drill1.02mm; MPN 640456-2; Digi-Key_PN A1921-ND
LED_BR1: LED_Dual_AKKA; LED_Kingbright_APHBM2012_2x1.25mm
LED_RG1: LED_Dual_AKKA; LED_Kingbright_APHBM2012_2x1.25mm
R21, R49, R50, R51, R59: 10k; R_0402_1005Metric
R28: 499; R_0402_1005Metric
R60, R61, R62, R63: 220; R_0402_1005Metric
S1: PTS645SM43SMTR92_LFS; Switch_Tactile_SMD_6x6mm_PTS645; MPN PTS645SM43SMTR92 LFS; Digi-Key_PN CKN9112CT-ND
SW1, SW2, SW3, SW4, SW5: TACT_SW; ESWITCH_TL1105
Y1: 2-SMD no lead; Crystal_SMD_3215-2Pin_3.2x1.5mm

Connections:
GND: C2.2, C28.2, C29.1, C36.2, C37.2, C41.1, C42.1, ESP32.1 (GND), ESP32.2 (GND), ESP32.30 (GND), ESP32.42 (GND), ESP32.43 (GND), ESP32.46 (GND), J3.3 (GND), J3.5 (GND), J4.4, R49.1, R50.1, R51.1, R59.1, R60.1, R62.1, S1.3, S1.4, SW1.2; also elsewhere on the board
MCU_5V_EN: ESP32.17 (GPIO13/ADC2_CH2); also elsewhere on the board
MCU_ADC_BAT: ESP32.15 (GPIO11/ADC2_CH0); also elsewhere on the board
MCU_ADC_BAT_CTRL: ESP32.7 (GPIO3/ADC1_CH2); also elsewhere on the board
MCU_ADC_IBAT: ESP32.9 (GPIO5/ADC1_CH4); also elsewhere on the board
MCU_ADC_IPV: ESP32.13 (GPIO9/ADC1_CH8); also elsewhere on the board
MCU_ADC_PV: ESP32.14 (GPIO10/ADC1_CH9); also elsewhere on the board
MCU_ADC_PV_CTRL: ESP32.41 (GPIO45); also elsewhere on the board
MCU_BOOT0: C41.2, ESP32.4 (GPIO0/BOOT), S1.1, S1.2
MCU_CTRL_B1: ESP32.6 (GPIO2/ADC1_CH1), R49.2, SW2.2
MCU_CTRL_B2: ESP32.28 (GPIO33), R50.2, SW3.2
MCU_CTRL_B3: ESP32.10 (GPIO6/ADC1_CH5), R51.2, SW4.2
MCU_CTRL_USER: ESP32.44 (GPIO46), R59.2, SW5.2
MCU_FLASH_LIGHTS: ESP32.12 (GPIO8/ADC1_CH7); also elsewhere on the board
MCU_INA181_VDD: ESP32.22 (ADC2_CH6/DAC_1/GPIO18); also elsewhere on the board
MCU_L1_ONOFFSIG: ESP32.11 (GPIO7/ADC1_CH6); also elsewhere on the board
MCU_L2_ONOFFSIG: ESP32.26 (SPI_CS1/GPIO26); also elsewhere on the board
MCU_L3_ONOFFSIG: ESP32.25 (GPIO21); also elsewhere on the board
MCU_LED_BR: ESP32.16 (GPIO12/ADC2_CH1), LED_BR1.1 (A1), R63.2
MCU_LED_RG: ESP32.21 (ADC2_CH7/DAC_2/GPIO17), LED_RG1.1 (A1), R61.2
MCU_LMV324_VDD: ESP32.18 (GPIO14/ADC2_CH3); also elsewhere on the board
MCU_MPPT_ENABLE: ESP32.31 (GPIO35); also elsewhere on the board
MCU_MTCK: ESP32.35 (MTCK/JTAG/GPIO39), J3.4 (SWDCLK/TCK)
MCU_MTDI: ESP32.37 (MTDI/JTAG/GPIO41), J3.8 (NC/TDI)
MCU_MTDO: ESP32.36 (MTDO/JTAG/GPIO40), J3.6 (SWO/TDO)
MCU_MTMS: ESP32.38 (MTMS/JTAG/GPIO42), J3.2 (SWDIO/TMS)
MCU_OCP_BAT: ESP32.5 (GPIO1/ADC1_CH0); also elsewhere on the board
MCU_PVDIRECTSWITCH: ESP32.8 (GPIO4/ADC1_CH3); also elsewhere on the board
MCU_PWM_L1: ESP32.34 (GPIO38); also elsewhere on the board
MCU_PWM_L2: ESP32.33 (GPIO37); also elsewhere on the board
MCU_PWM_L3: ESP32.32 (GPIO36); also elsewhere on the board
MCU_PWM_MPPT: ESP32.29 (GPIO34); also elsewhere on the board
MCU_RST: C28.1, C36.1, ESP32.45 (CHIP/PU/RESET), J3.10 (~RESET), R21.2, SW1.1
MCU_RX: ESP32.40 (GPIO44/U0RXD/PROG), J4.1
MCU_TX: J4.2, R28.1
MCU_VDD: C29.2, C42.2, ESP32.3 (3V3), J3.1 (VTref), J4.3, LED_BR1.4 (A2), LED_RG1.4 (A2), R21.1, SW2.1, SW3.1, SW4.1, SW5.1; also elsewhere on the board
unnamed: C2.1, ESP32.19 (GPIO15/ADC2_CH4/XTAL_32K_P), Y1.2
unnamed: C37.1, ESP32.20 (GPIO16/ADC2_CH5/XTAL_32K_N), Y1.1
unnamed: ESP32.39 (GPIO43/U0TXD/PROG), R28.2
unnamed: LED_BR1.2 (K1), R62.2
unnamed: LED_BR1.3 (K2), R63.1
unnamed: LED_RG1.2 (K1), R60.2
unnamed: LED_RG1.3 (K2), R61.1
USB_D+: ESP32.24 (USB_D+/ADC2_CH9/GPIO20), J5.2; also elsewhere on the board
USB_D-: ESP32.23 (USB_D-/ADC2_CH8/GPIO19), J5.1; also elsewhere on the board

Notes on the sheet:
USB_DFU

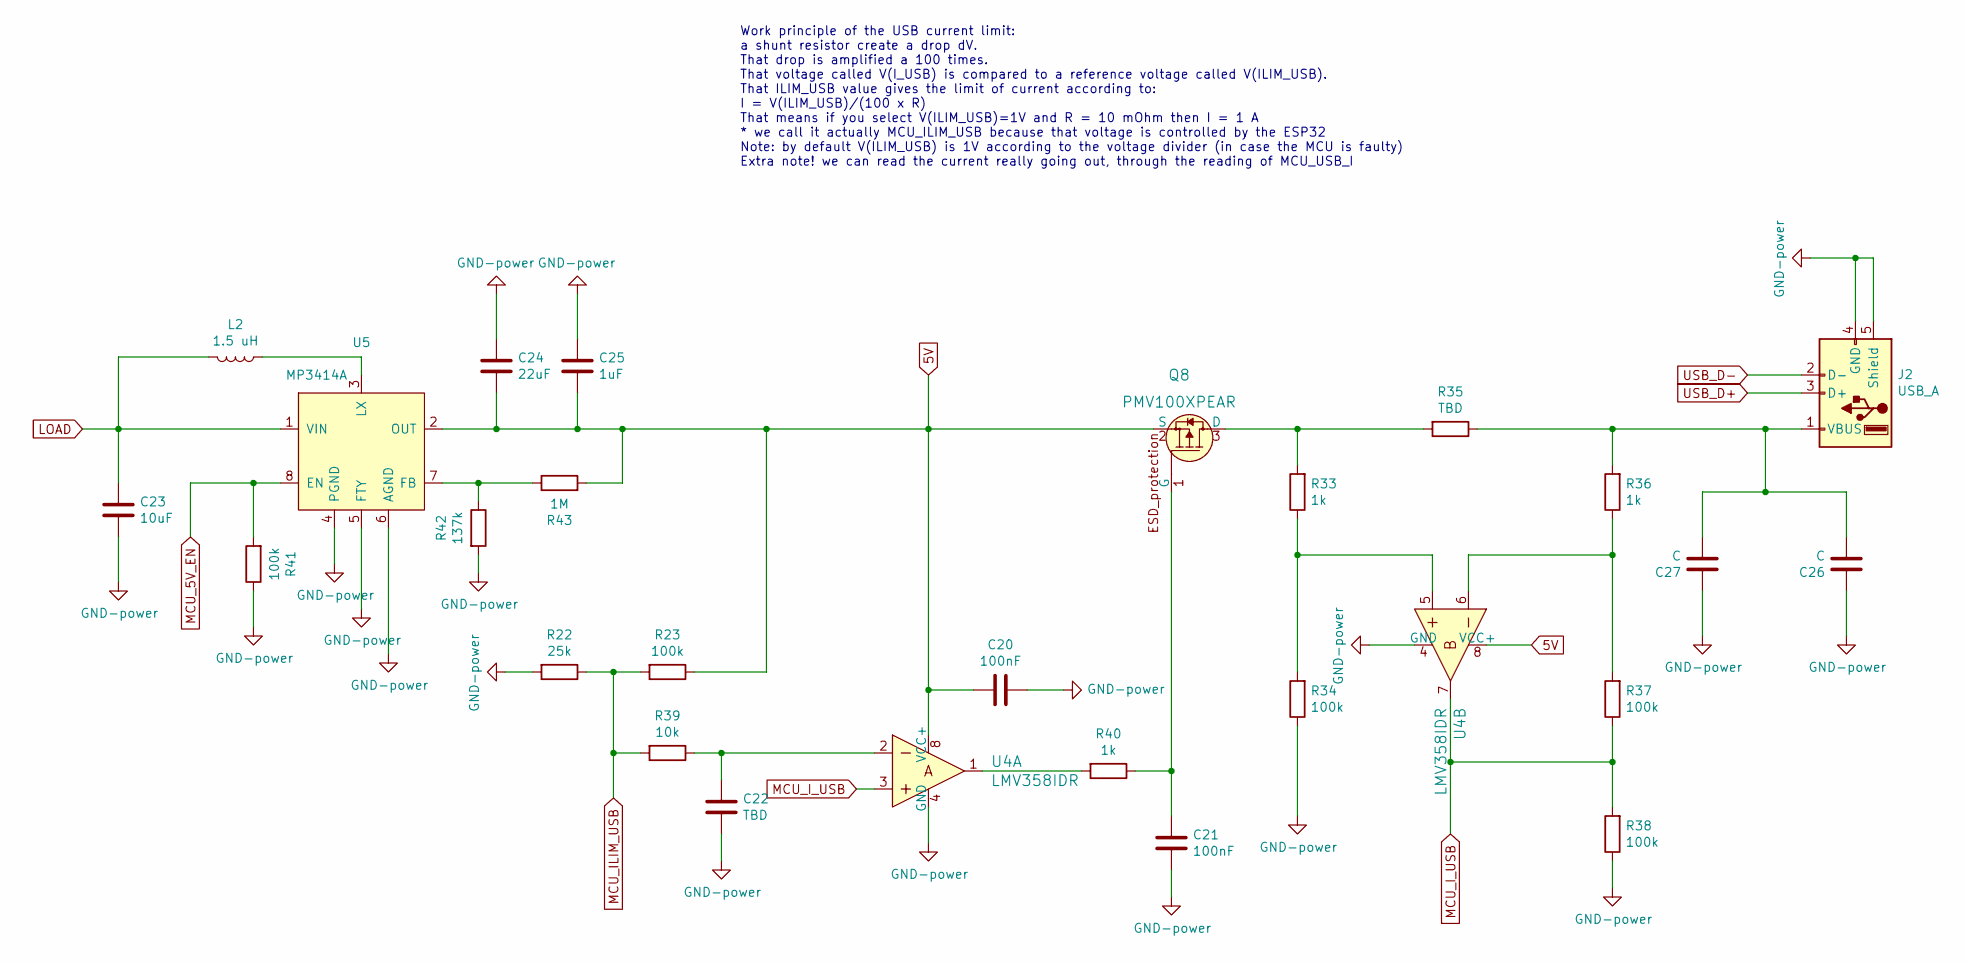
[picture p26: schematic USB.kicad_sch]

Parts:
C20: 100nF; C_0402_1005Metric
C21: 100nF; C_0603_1608Metric
C22: TBD; C_0603_1608Metric
C23: 10uF; C_0805_2012Metric
C24: 22uF; C_0805_2012Metric
C25: 1uF; C_0603_1608Metric
C26, C27: C; C_1210_3225Metric
J2: USB_A; USB_A_CONNFLY_DS1095-WNR0
L2: 1.5 uH; L_Taiyo-Yuden_NR-60xx
Q8: PMV100XPEAR; SOT-23-3; MPN PMV100XPEAR
R22: 25k; R_0603_1608Metric
R23, R34, R37, R38, R41: 100k; R_0603_1608Metric
R33, R36, R40: 1k; R_0603_1608Metric
R35: TBD; R_0805_2012Metric
R39: 10k; R_0603_1608Metric
R42: 137k; R_0603_1608Metric
R43: 1M; R_0603_1608Metric
U4: LMV358IDR; SOIC-8_W3.9mm; MPN LMV358IDR; Digi-Key_PN 296-9571-1-ND
U5: MP3414A

Connections:
5V: C20.2, C24.2, C25.2, Q8.2 (S), R23.1, R43.2, U4.8 (VCC+), U5.2 (OUT); also elsewhere on the board
GND: C20.1, C21.1, C22.2, C23.2, C24.1, C25.1, C26.1, C27.1, J2.4 (GND), J2.5 (Shield), R22.2, R34.1, R38.1, R41.1, R42.2, U4.4 (GND), U5.4 (PGND), U5.5 (FTY), U5.6 (AGND); also elsewhere on the board
LOAD: C23.1, L2.2, U5.1 (VIN); also elsewhere on the board
MCU_5V_EN: R41.2, U5.8 (EN); also elsewhere on the board
MCU_ILIM_USB: R22.1, R23.2, R39.2
MCU_I_USB: R37.1, R38.2, U4.3, U4.7
unnamed: C21.2, Q8.1 (G), R40.1
unnamed: C22.1, R39.1, U4.2
unnamed: C26.2, C27.2, J2.1 (VBUS), R35.1, R36.2
unnamed: L2.1, U5.3 (LX)
unnamed: Q8.3 (D), R33.2, R35.2
unnamed: R33.1, R34.2, U4.5
unnamed: R36.1, R37.2, U4.6
unnamed: R40.2, U4.1
unnamed: R42.1, R43.1, U5.7 (FB)
USB_D+: J2.3 (D+); also elsewhere on the board
USB_D-: J2.2 (D-); also elsewhere on the board

Notes on the sheet:
Work principle of the USB current limit: a shunt resistor create a drop dV. That drop is amplified a 100 times. That voltage called V(I_USB) is compared to a reference voltage called V(ILIM_USB). That ILIM_USB value gives the limit of current according to: I = V(ILIM_USB)/(100 x R) That means if yo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

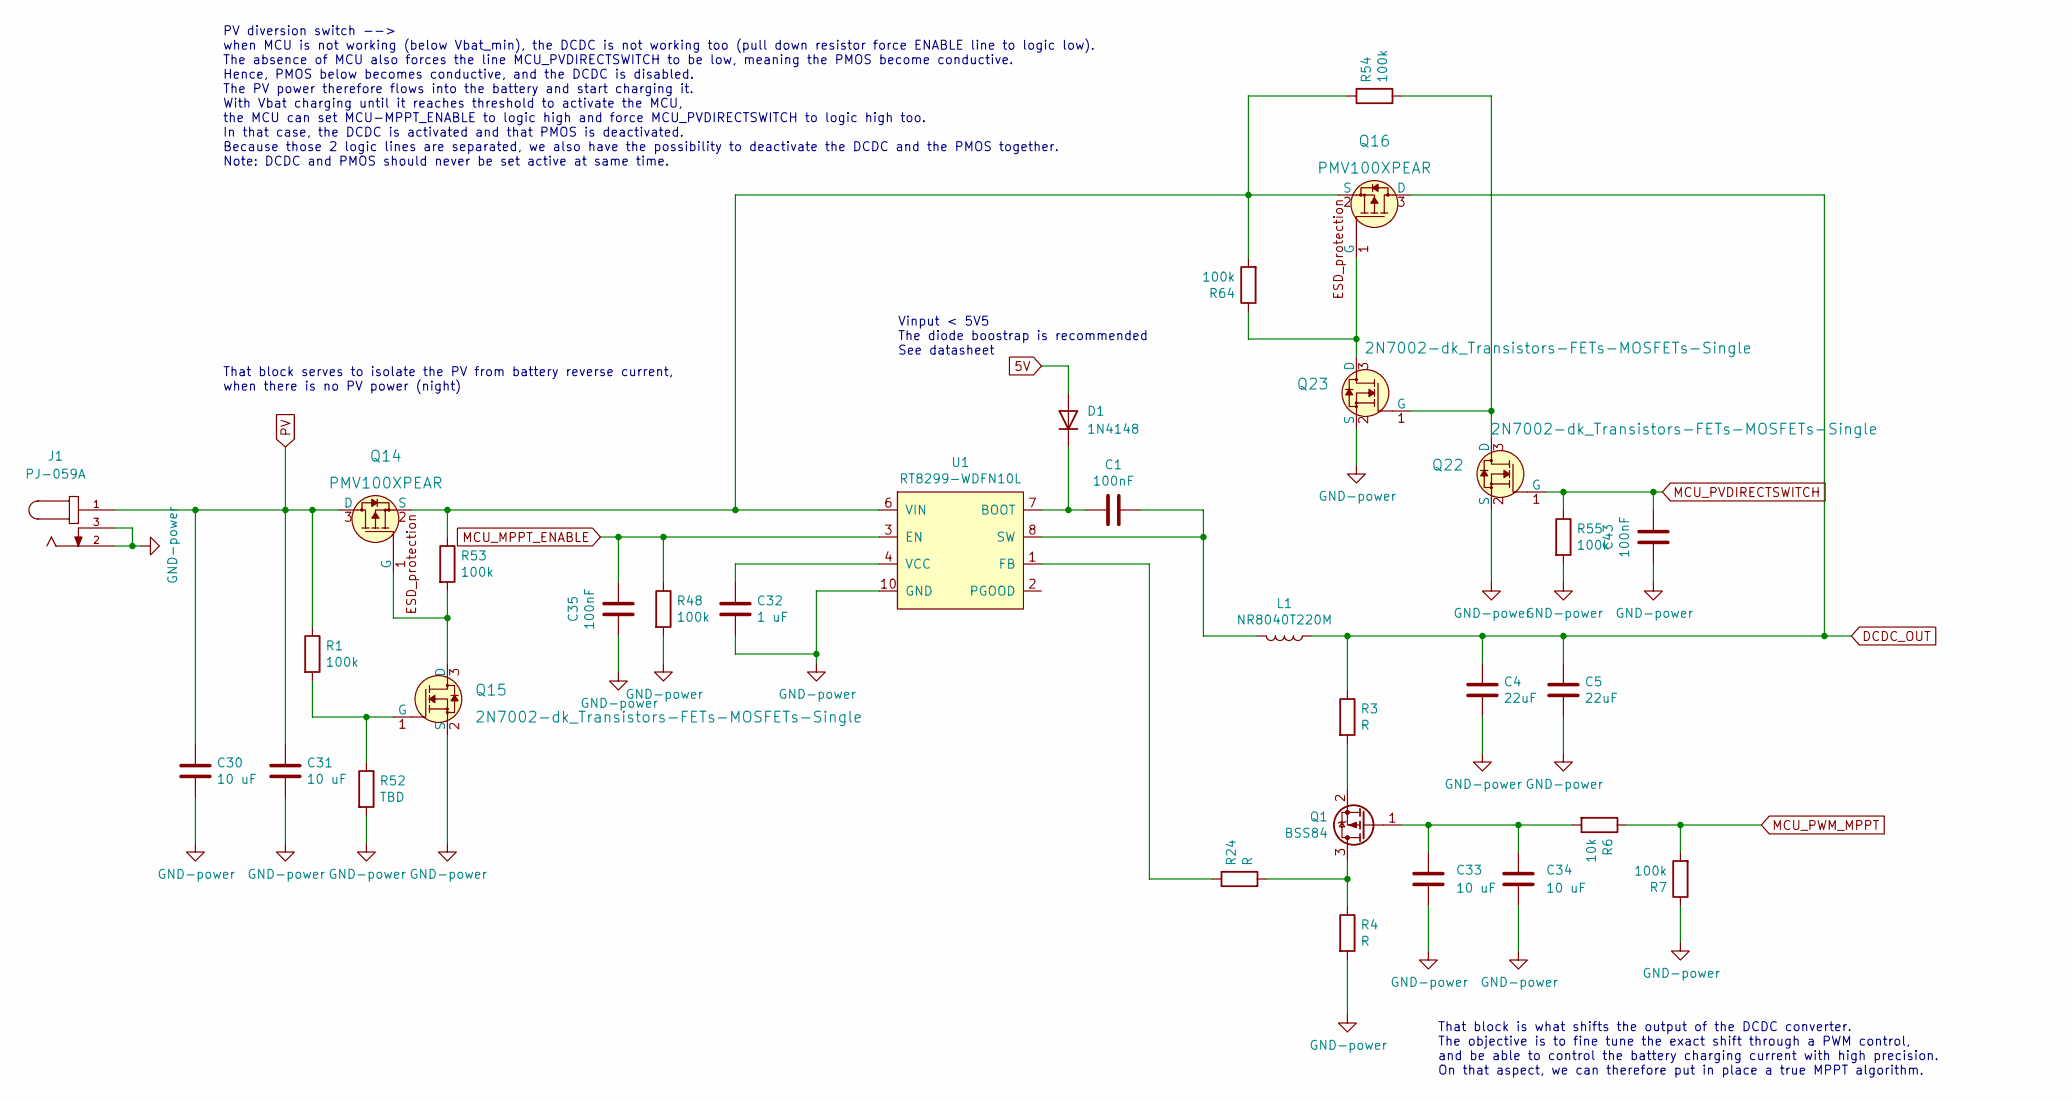
[picture p27: schematic untitled.kicad_sch]

Parts:
C1, C35, C43: 100nF; C_0402_1005Metric
C4, C5: 22uF; C_0805_2012Metric
C30, C31: 10 uF; C_0805_2012Metric
C32: 1 uF; C_0402_1005Metric
C33, C34: 10 uF; C_0603_1608Metric
D1: 1N4148; D_SOD-123
J1: PJ-059A; CUI_PJ-059A; PARTREV 1.02
L1: NR8040T220M; L_Taiyo-Yuden_NR-80xx
Q1: BSS84; SOT-23
Q14, Q16: PMV100XPEAR; SOT-23-3; MPN PMV100XPEAR
Q15, Q22, Q23: 2N7002-dk_Transistors-FETs-MOSFETs-Single; SOT-23-3; MPN 2N7002; Digi-Key_PN 2N7002NCT-ND
R1, R7, R48, R53, R54, R55, R64: 100k; R_0402_1005Metric
R3, R4, R24: R; R_0402_1005Metric
R6: 10k; R_0402_1005Metric
R52: TBD; R_0402_1005Metric
U1: RT8299-WDFN10L; RT8299-WDFN

Connections:
5V: D1.2 (A); also elsewhere on the board
DCDC_OUT: C4.1, C5.1, L1.1, Q16.3 (D), R3.1; also elsewhere on the board
GND: C4.2, C5.2, C30.2, C31.2, C32.2, C33.2, C34.2, C35.1, C43.1, J1.2, J1.3, Q15.2 (S), Q22.2 (S), Q23.2 (S), R4.2, R7.1, R48.2, R52.2, R55.2, U1.10 (GND); also elsewhere on the board
MCU_MPPT_ENABLE: C35.2, R48.1, U1.3 (EN); also elsewhere on the board
MCU_PVDIRECTSWITCH: C43.2, Q22.1 (G), R55.1; also elsewhere on the board
MCU_PWM_MPPT: R6.1, R7.2; also elsewhere on the board
unnamed: C1.1, D1.1 (K), U1.7 (BOOT)
unnamed: C1.2, L1.2, U1.8 (SW)
unnamed: C32.1, U1.4 (VCC)
unnamed: C33.1, C34.1, Q1.1 (G), R6.2
unnamed: Q1.2 (S), R3.2
unnamed: Q1.3 (D), R4.1, R24.2
unnamed: Q14.1 (G), Q15.3 (D), R53.2
unnamed: Q14.2 (S), Q16.2 (S), R53.1, R54.1, R64.2, U1.6 (VIN)
unnamed: Q15.1 (G), R1.2, R52.1
unnamed: Q16.1 (G), Q23.3 (D), R64.1
unnamed: Q22.3 (D), Q23.1 (G), R54.2
unnamed: R24.1, U1.1 (FB)
PV: C30.1, C31.1, J1.1, Q14.3 (D), R1.1; also elsewhere on the board

Notes on the sheet:
That block is what shifts the output of the DCDC converter. The objective is to fine tune the exact shift through a PWM control, and be able to control the battery charging current with high precision. On that aspect, we can therefore put in place a true MPPT algorithm.
PV diversion switch --> when MCU is not working (below Vbat_min), the DCDC is not working too (pull down resistor force ENABLE line to logic low). The absence of MCU also forces the line MCU_PVDIRECTSWITCH to be low, meaning the PMOS become conductive. Hence, PMOS below becomes conductive, and the 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
Vinput < 5V5 The diode boostrap is recommended See datasheet
That block serves to isolate the PV from battery reverse current, when there is no PV power (night)

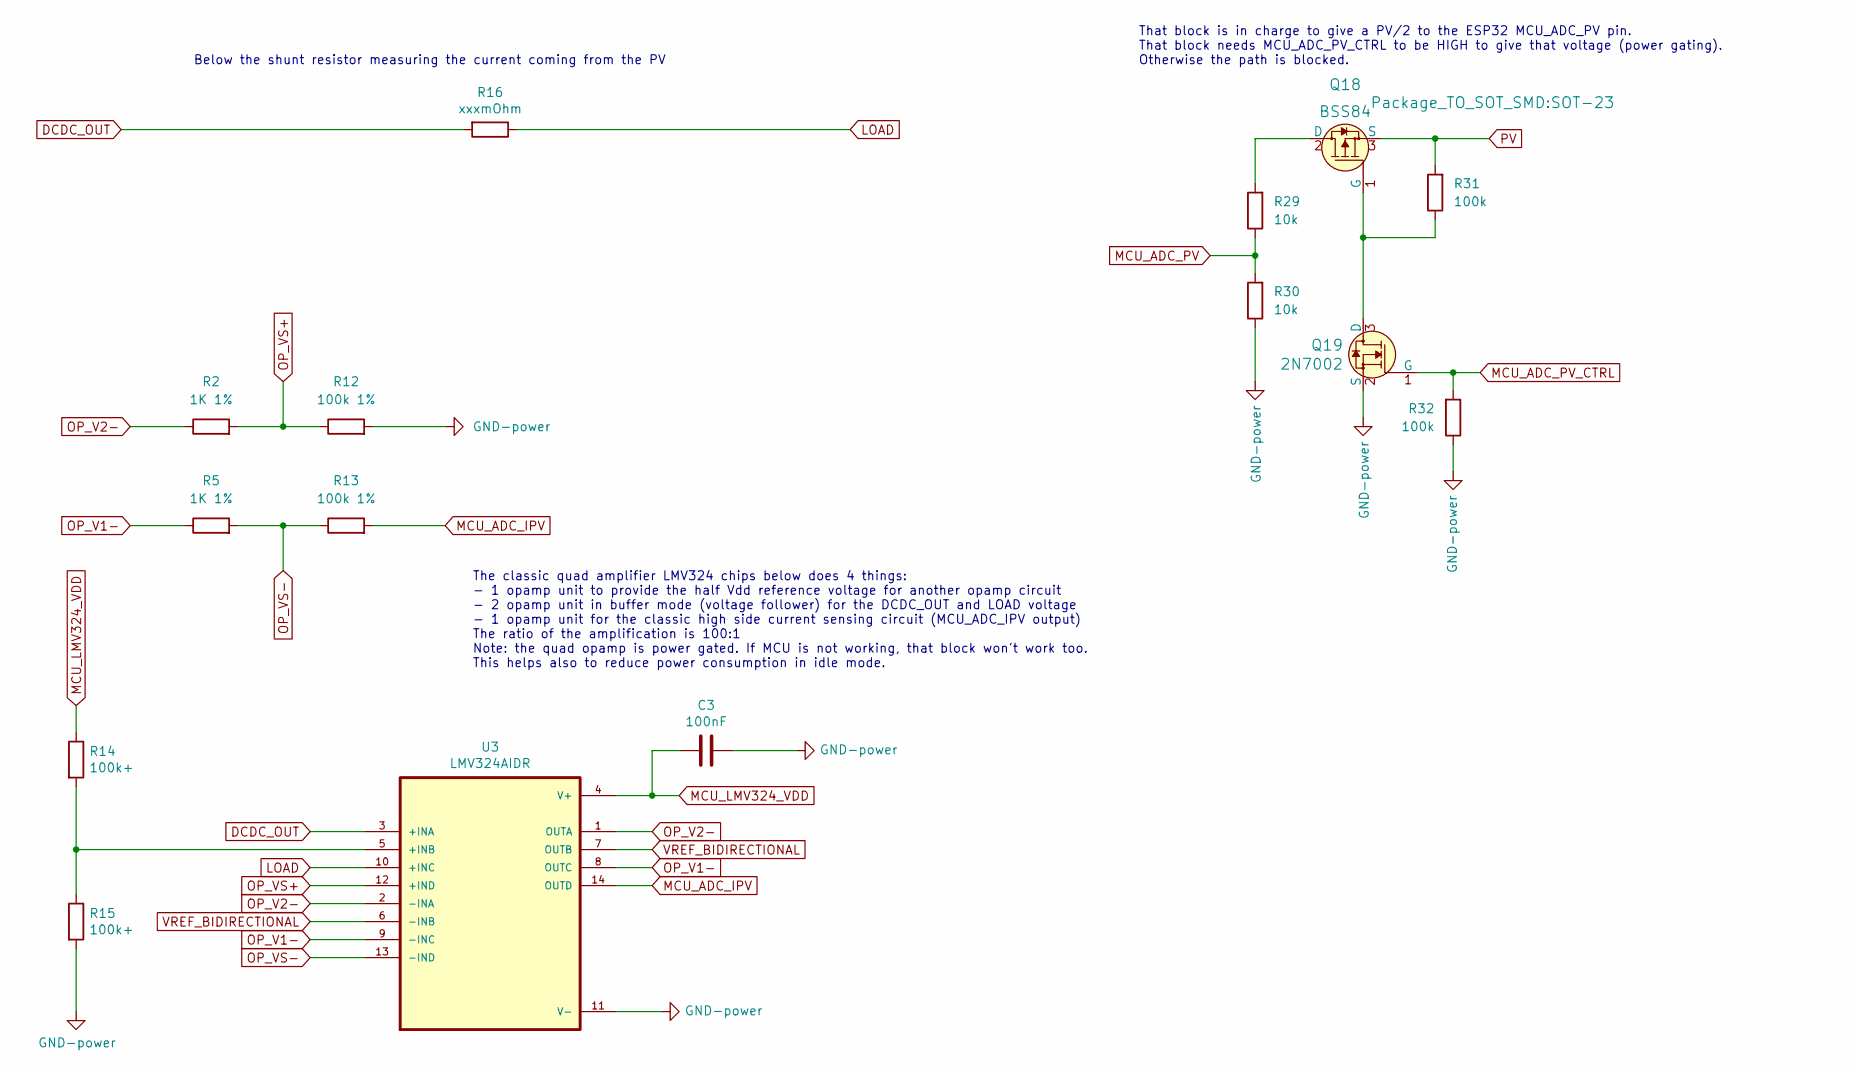
[picture p28: schematic pvsense.kicad_sch]

Parts:
C3: 100nF; C_0402_1005Metric
Q18: BSS84; SOT-23; MPN BSS84; Digi-Key_PN BSS84CT-ND
Q19: 2N7002; SOT-23; MPN 2N7002; Digi-Key_PN 2N7002NCT-ND
R2, R5: 1K 1%; R_0402_1005Metric
R12, R13: 100k 1%; R_0402_1005Metric
R14, R15: 100k+; R_0603_1608Metric
R16: xxxmOhm; R_1206_3216Metric
R29, R30: 10k; R_0402_1005Metric
R31, R32: 100k; R_0402_1005Metric
U3: LMV324AIDR; SOIC127P600X175-14N

Connections:
DCDC_OUT: R16.2, U3.3 (+INA); also elsewhere on the board
GND: C3.1, Q19.2 (S), R12.2, R15.2, R30.1, R32.1, U3.11 (V-); also elsewhere on the board
LOAD: R16.1, U3.10 (+INC); also elsewhere on the board
MCU_ADC_IPV: R13.2, U3.14 (OUTD); also elsewhere on the board
MCU_ADC_PV: R29.1, R30.2; also elsewhere on the board
MCU_ADC_PV_CTRL: Q19.1 (G), R32.2; also elsewhere on the board
MCU_LMV324_VDD: C3.2, R14.1, U3.4 (V+); also elsewhere on the board
unnamed: Q18.1 (G), Q19.3 (D), R31.1
unnamed: Q18.2 (D), R29.2
unnamed: R14.2, R15.1, U3.5 (+INB)
OP_V1-: R5.1, U3.8 (OUTC), U3.9 (-INC)
OP_V2-: R2.1, U3.1 (OUTA), U3.2 (-INA)
OP_VS+: R2.2, R12.1, U3.12 (+IND)
OP_VS-: R5.2, R13.1, U3.13 (-IND)
PV: Q18.3 (S), R31.2; also elsewhere on the board
VREF_BIDIRECTIONAL: U3.6 (-INB), U3.7 (OUTB); also elsewhere on the board

Notes on the sheet:
The classic quad amplifier LMV324 chips below does 4 things: - 1 opamp unit to provide the half Vdd reference voltage for another opamp circuit - 2 opamp unit in buffer mode (voltage follower) for the DCDC_OUT and LOAD voltage - 1 opamp unit for the classic high side current sensing circuit (MCU_AD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
Below the shunt resistor measuring the current coming from the PV
That block is in charge to give a PV/2 to the ESP32 MCU_ADC_PV pin. That block needs MCU_ADC_PV_CTRL to be HIGH to give that voltage (power gating). Otherwise the path is blocked.
