jcampos83/Offgridforall_SHS5/SHS_DCDC/SHS_DCDC.kicad_pcb

## KiCad design SHS_DCDC/SHS_DCDC.kicad_pcb (continued)

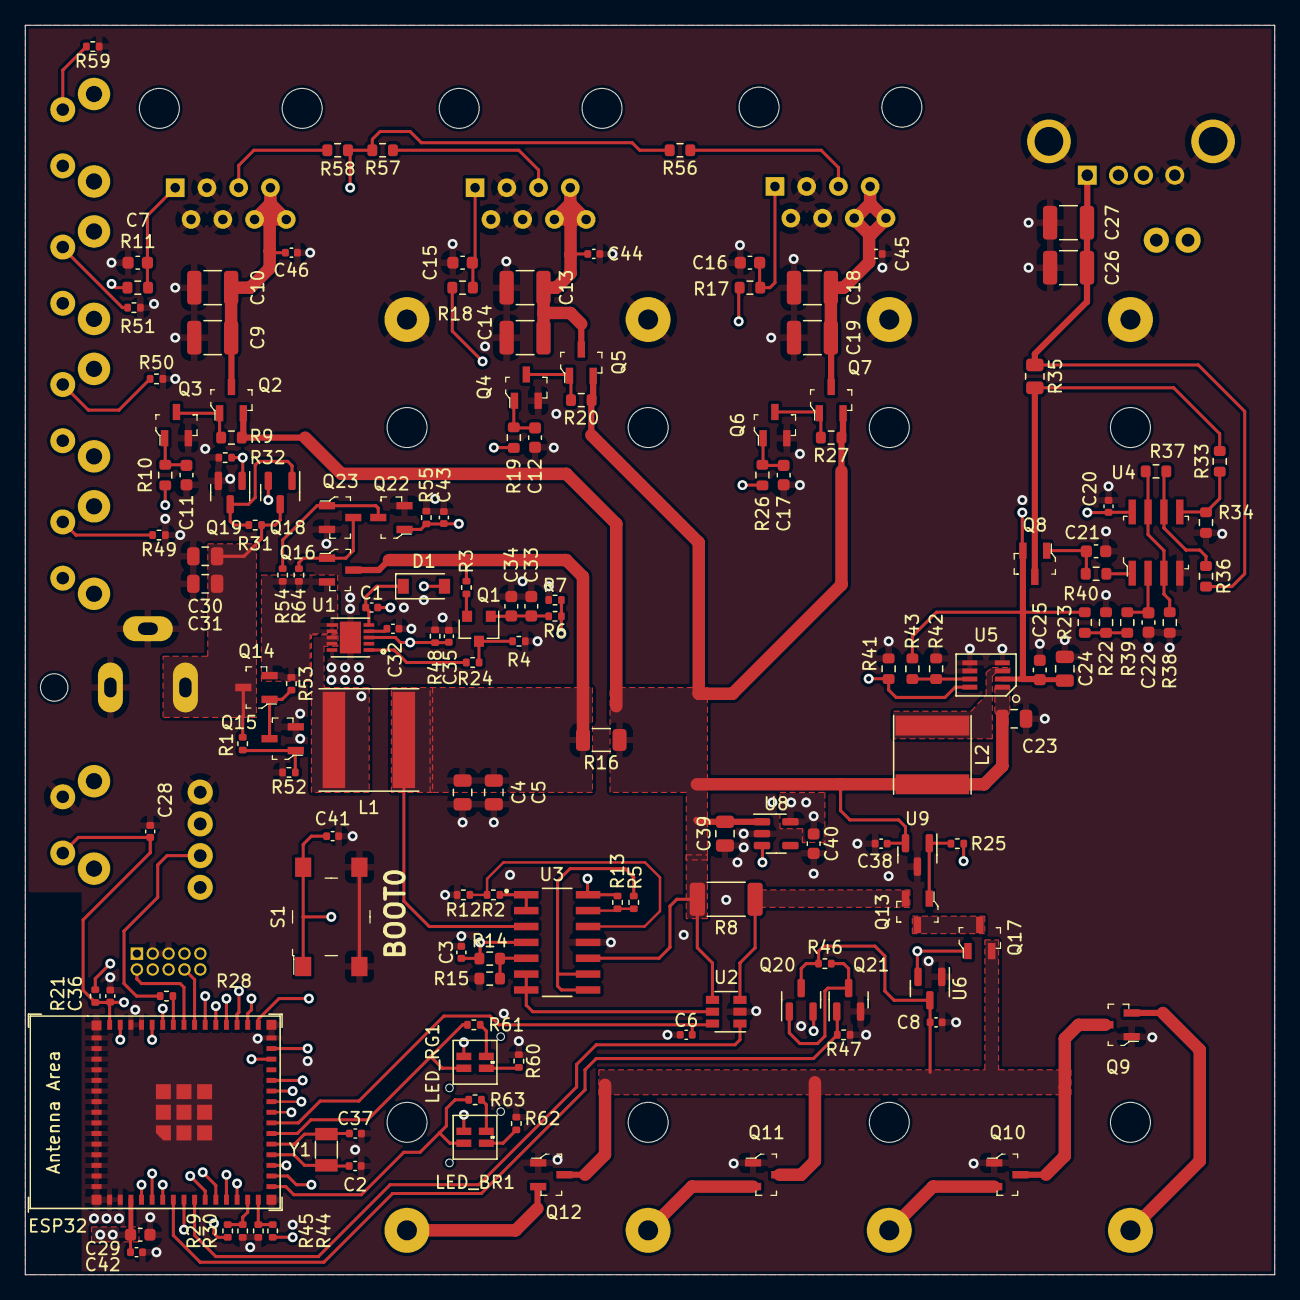
[picture p29: board SHS_DCDC.kicad_pcb from above]

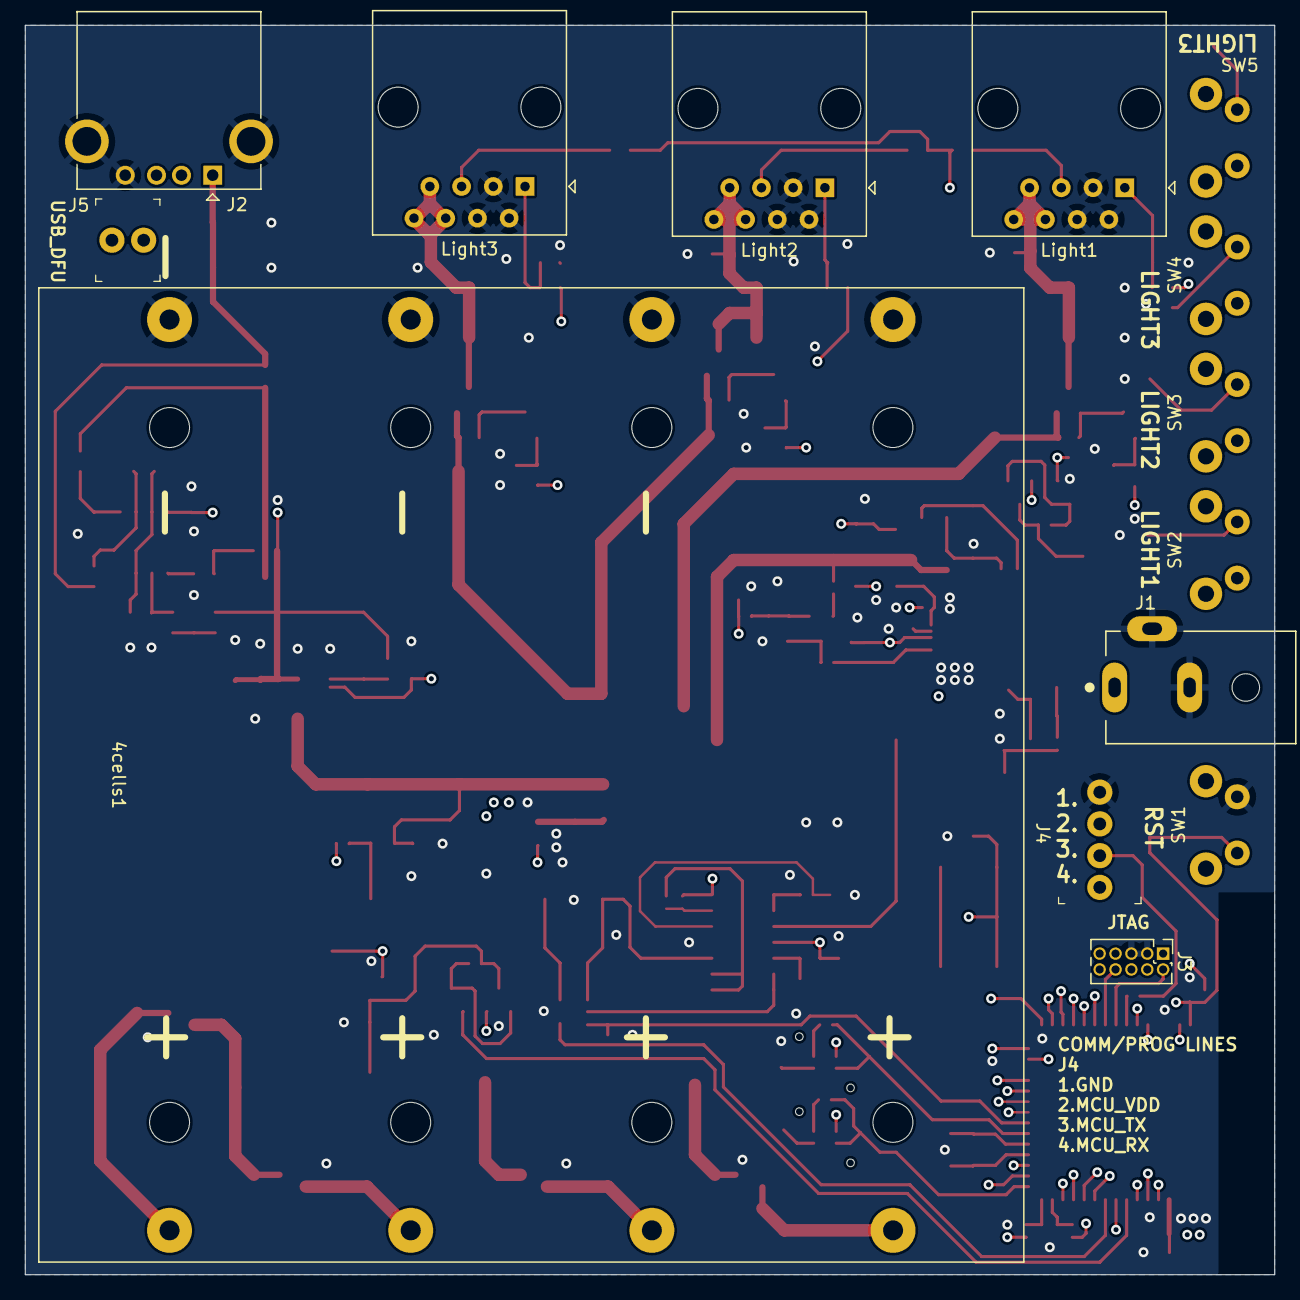
[picture p30: board SHS_DCDC.kicad_pcb from below]

Board: 6 copper layers, 100.0 x 100.0 mm, 165 parts (14 on the bottom side), 106 nets.
