jcampos83/Offgridforall_SHS5/(commit log)

2022-05-05 esp32 s2 mini placed
    [BAT.sch, LOAD.sch, MCU.sch, SHS_DCDC.kicad_pcb, SHS_DCDC.sch, USB.sch]
2022-11-20 Commit_GitHubgDesktop
    Try of Github desktop
    [BAT.kicad_sch, LOAD.kicad_sch, MCU.kicad_sch, SHS_DCDC.kicad_pcb, SHS_DCDC.kicad_sch, SHS_DCDC.sch, USB.kicad_sch, pvsense.kicad_sch]
2023-01-23 Ubuntu transfer
    Commit before transfer onto Ubuntu
    [BAT.kicad_sch, MCU.kicad_sch, SHS_DCDC.kicad_pcb, SHS_DCDC.kicad_sch, USB.kicad_sch]
2023-02-19 Commit_190223
    Normal commit
    [BAT.kicad_sch, MCU.kicad_sch, SHS_DCDC.kicad_pcb, USB.kicad_sch, pvsense.kicad_sch]
2023-02-19 Commit_Fix
    Fix to move back to ESP32
    [BAT.kicad_sch, MCU.kicad_sch, SHS_DCDC.kicad_pcb, SHS_DCDC.kicad_sch, USB.kicad_sch]
2023-03-01 Commit010323
    Progress on the USB current limitation
    [SHS_DCDC.kicad_pcb, SHS_DCDC.kicad_sch, USB.kicad_sch]
2023-03-02 Error fix on DCDC block
    Wrong pinout on DCDC block that needed to be fixed
    [SHS_DCDC.kicad_pcb, SHS_DCDC.kicad_sch, USB.kicad_sch]
2023-03-14 Bif fix
    Big fix on DCDCOUT and LOAD signal
    [SHS_DCDC.kicad_pcb]
2023-03-21 OCP
    Adding overcharge protection
    [BAT.kicad_sch, LOAD.kicad_sch, MCU.kicad_sch, SHS_DCDC.kicad_pcb, SHS_DCDC.kicad_sch, USB.kicad_sch]
2023-03-22 6 layers PCB
    Decision to move to a 6 layers PCB to ease the PCB routing
    [BAT.kicad_sch, MCU.kicad_sch, SHS_DCDC.kicad_pcb, SHS_DCDC.kicad_sch, USB.kicad_sch, pvsense.kicad_sch]
2023-03-23 PV & BAT V sense
    Adding 2 same blocks allowing the measure by ADC of the PV and Battery voltage on demand through power gating technique
    [BAT.kicad_sch, MCU.kicad_sch, SHS_DCDC.kicad_pcb, SHS_DCDC.kicad_sch, USB.kicad_sch, pvsense.kicad_sch, untitled.kicad_sch]
2023-03-27 ADC_PV & BAT
    Blocks related to ADC reading of PV and BAT added on the physical board.
    [BAT.kicad_sch, MCU.kicad_sch, SHS_DCDC.kicad_pcb, SHS_DCDC.kicad_sch, USB.kicad_sch, untitled.kicad_sch]
2023-04-17 3D rendering progress
    [CUI_DEVICES_PJ-202A.step, IND_TAIYO_NR6028_TAY.step, IND_TAIYO_NR8040_TAY.step, LMV324AIDR.STEP, LMV358IDR.stp, MCU.kicad_sch, SHS_DCDC.kicad_pcb, SHS_DCDC.kicad_sch]
2023-04-24 3D missing part
    Many parts with no 3D view, have completed all of them
    [MCU.kicad_sch, PJ-059A.stp, SHS_DCDC.kicad_pcb, SHS_DCDC.kicad_sch, TL1105SFxxxx.stp, TSOT23-8_MP3414A_MNP.step, USB.kicad_sch, XTAL_ECX-34R_ECS.step]
2023-05-09 ESP32 cornering
    Moving the ESP32 on the bottom corner of the board
    [SHS_DCDC.kicad_pcb]
2023-08-12 DFU update
    PCB update to setup 3 ways of FW/Debug capability:
    1. JTAG (FW & Debug)
    2. USB DFU (FW & Debug)
    3. UART (FW only)
    With BOOT0 button installed too
    [BAT.kicad_sch, LOAD.kicad_sch, MCU.kicad_sch, PTS645SM43SMTR92LFS.stp, SHS_DCDC.kicad_pcb, SHS_DCDC.kicad_sch, USB.kicad_sch, pvsense.kicad_sch]
2023-08-13 PV input Power
    Big modification on the PV input power protection, precisely on the reverse battery current protection, and also on the switch between direct PV charging and the DCDC converter
    [LOAD.kicad_sch, MCU.kicad_sch, SHS_DCDC.kicad_pcb, SHS_DCDC.kicad_sch, USB.kicad_sch, pvsense.kicad_sch, untitled.kicad_sch]
2023-08-13 Light bulb drive update
    [LOAD.kicad_sch, SHS_DCDC.kicad_pcb, SHS_DCDC.kicad_sch, USB.kicad_sch]
2023-08-24 Newbutton
    New button whose job is to tell the MCU the user wants to establish a BLE connection with the SHS, in order to configure it.
    [MCU.kicad_sch, SHS_DCDC.kicad_pcb, SHS_DCDC.kicad_sch, USB.kicad_sch]
2023-09-13 LED
    Placement of the 2nd dual LED
    [BIVAR__INC_VLP-400-F.step, MCU.kicad_sch, SHS_DCDC.kicad_sch, USB.kicad_sch]
2023-09-28 Final_check stage
    [BAT.kicad_sch, LOAD.kicad_sch, MCU.kicad_sch, SHS_DCDC.kicad_sch, USB.kicad_sch, pvsense.kicad_sch, untitled.kicad_sch]
2023-10-16 Starting DRC
    [MCU.kicad_sch, SHS_DCDC.kicad_pcb, USB.kicad_sch]
2023-10-17 Commit before reannotation
    Plan to test the reannotation feature.
    [LOAD.kicad_sch, MCU.kicad_sch, SHS_DCDC.kicad_pcb, SHS_DCDC.kicad_sch, USB.kicad_sch, pvsense.kicad_sch, untitled.kicad_sch]
2023-10-17 Commit update
    Failure of testing the geographical reannotation feature. I have cancelled it myself and now i commit to the normal version.
    [SHS_DCDC.kicad_pcb]
2023-10-24 Testpoints
    All the tests points have been placed
    [BAT.kicad_sch, KEYSTONE - 5029.step, LOAD.kicad_sch, MCU.kicad_sch, SHS_DCDC.kicad_sch, USB.kicad_sch, pvsense.kicad_sch, untitled.kicad_sch]
2023-10-25 Gerber
    Gerber output, ready to send to JLCPCB
    [LOAD.kicad_sch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]
