jcampos83/Offgridforall_SHS5/(notices)

Notices in the files:
SHS_DCDC/Components/3D model/USB-A-S-S-W-TH.stp:
author */ ('License CC BY-ND 4.0'),
